npeixoto64/ExitGuardian/docs/requirements/requirements.md

# Project Requirements

## 1. Introduction

**Project Name:** Exit Guardian
**Version:** v3.0.0
**Author(s):** Nuno Peixoto
**Date:** 26/04/2026
**Purpose:** A plug-in device that triggers an alert with a buzzer at the moment the exit door is open if any window/door is previously opened. When the exit door is closed, the alert is always turned off. The device is intended for use in residential and commercial buildings.

## 2. Overall System Requirements

```{req} System composed of wireless sensors and a single gateway
:id: SR_001
:status: approved
:component: system

The system shall be composed of one or more wireless sensors for windows/doors, one main-door sensor and a gateway.
```

```{req} Window/door sensors and main-door sensors type
:id: SR_002
:status: approved
:component: system

The windows/doors and main-door sensor are the same. They are differentiated at the pairing moment with the gateway.
```

```{req} Sensor reports window/door open close events, user forced update status events and pair/unpair requests
:id: SR_003
:status: approved
:component: sensor

The wireless sensors shall send to the gateway, via RF, the current state of the monitored window/door (OPEN or CLOSED) together with a request field (PAIR_REQUEST, UNPAIR_REQUEST or NONE). A packet shall be sent on every window or door open/close event and on every sensor push-button press.
```

```{req} Sensor powered by replaceable battery
:id: SR_004
:status: approved
:component: sensor

The wireless sensors shall be powered by a replaceable battery.
```

```{req} Main-door sensor
:id: SR_005
:status: approved
:component: sensor

The main-door sensor is a regular window/door sensor but it's paired as a main door sensor. When an open door event is sent, the gateway evaluates the status of other sensors in its internal memory and beeps in case an window or door is open. When the door sends a close event the beep ends.
```

```{req} Gateway power supply
:id: SR_006
:status: approved
:component: gateway

The gateway shall be powered by 230 V AC, directly from wall power socket.
```

```{req} Gateway buzzer
:id: SR_007
:status: approved
:component: gateway

The gateway shall have a buzzer.
```

```{req} Gateway button for reset and pairing
:id: SR_008
:status: approved
:component: gateway

The gateway shall have a push button to allow a hard factory reset and to pair/unpair the sensors.
```

```{req} Gateway LEDs
:id: SR_009
:status: approved
:component: gateway

The gateway shall have three LEDs (blue, yellow, and red) to indicate its status.
```

```{req} LED usage (heartbeat, config, alerts)
:id: SR_010
:status: approved
:component: gateway

The gateway shall use LEDs to indicate:
  - heartbeat — blue;
  - sensors low-battery condition (visible only in monitoring mode) and pairing/unpairing mode — yellow;
  - waiting-for-configuration and active alert — red.
```

## 3. System Functional Requirements

```{req} Sensor sends a packet on window/door open/close event or push-button event
:id: FR_001
:status: approved
:component: sensor

When the monitored window/door or main-door is opened or closed, or when the sensor push button is pressed, the sensor shall send a data packet to the gateway via RF.
```

```{req} Sensor packet contents
:id: FR_002
:status: approved
:component: sensor

Each sensor packet shall include:
  (a) the sensor's unique identifier (FR_003);
  (b) battery status — LOW (Vbat < threshold) or OK;
  (c) packet type ∈ {OPEN, CLOSE}, reflecting the current state of the monitored window/door at the time of transmission;
  (d) request type ∈ {PAIR_REQUEST, UNPAIR_REQUEST, NONE}, set to PAIR_REQUEST or UNPAIR_REQUEST when the packet is triggered by the sensor push button, and NONE otherwise.
```

```{req} Unique sensor ID
:id: FR_003
:status: approved
:component: sensor

Each sensor shall have a unique identifier (ID).
```

```{req} Blue LED heartbeat
:id: FR_004
:status: approved
:component: gateway

The gateway shall indicate it is operating properly by blinking the blue LED for 100 ms every two seconds since boot, in any operation mode.
```

```{req} Gateway operating modes
:id: FR_005
:status: approved
:component: gateway

The gateway shall support 3 modes of operation: waiting-for-configuration, pairing/unpairing sensors and monitoring.
```

```{req} Boot-time mode selection
:id: FR_006
:status: approved
:component: gateway

After boot, the gateway shall restore the paired sensor list and status from NVM and enter monitoring mode if at least one sensor is paired, otherwise waiting-for-configuration mode.
```

```{req} Red LED ON in waiting-for-configuration
:id: FR_007
:status: approved
:component: gateway

In waiting-for-configuration mode, the red LED shall remain ON continuously.
```

```{req} Red LED OFF in monitoring mode if no alert
:id: FR_008
:status: approved
:component: gateway

In monitoring mode with no active alert, the red LED shall remain OFF.
```

```{req} Factory reset enters waiting-for-configuration mode
:id: FR_009
:status: approved
:component: gateway

After a factory RESET event, the gateway shall enter waiting-for-configuration mode of operation.
```

```{req} Yellow LED functionality in waiting-for-configuration mode
:id: FR_010
:status: approved
:component: gateway

While in waiting-for-configuration mode, the yellow LED shall be OFF.
```

```{req} Monitor main-door open/close
:id: FR_011
:status: approved
:component: gateway

In monitoring mode, if the gateway receives a main-door open or close event it shall evaluate the alert logic.
```

```{req} Alert logic based on main-door and windows/doors
:id: FR_012
:status: approved
:component: system

In monitoring mode, the gateway shall maintain the last-known open/closed state of each paired sensor on windoes/doors. The alert condition shall be evaluated whenever the main door state changes or any paired sensor reports a state change, using the main-door state and the last-known state of each paired sensor: ALERT ⇔ (main door OPEN) ∧ (∃ paired sensor with last-known state OPEN). On entry to monitoring mode, each paired sensor's last-known state shall be initialized from NVM (NFR_008). Sensors with no prior report shall default to CLOSED.
```

```{req} Alert signal pattern
:id: FR_013
:status: approved
:component: gateway

After the alert condition (FR_012) becomes true, within 500 ms, the gateway shall:
  - (a) sound the buzzer for an intentional single 2 s ON pulse, and
  - (b) start blinking the red LED with a 200 ms period and 50% duty cycle.
 The red LED shall continue blinking while the alert condition remains true (any window open). When the alert condition becomes false, the buzzer pulse shall be truncated and the red LED shall return to the indication corresponding to the current operating mode (FR_007 / FR_008).
```

```{req} Push button short press or double press enters pairing/unpairing mode for window/door sensor and main-door sensor
:id: FR_014
:status: approved
:component: gateway

If the gateway is in monitoring or waiting-for-configuration mode and the push button is pressed and released in less or equal 2 s, or the push button is double pressed the gateway shall enter pairing/unpairing mode.
```

```{req} Only one main-door sensor is supported
:id: FR_015
:status: approved
:component: gateway

If a pairing request from a new (unpaired) sensor ID is received during main-door pairing mode (FR_023), it shall replace the existing main-door sensor in NVM. Pairing requests from the currently registered main-door sensor ID shall be ignored per FR_020.
```

```{req} Pairing/unpairing mode indicators and timeout
:id: FR_016
:status: approved
:component: gateway

In pairing/unpairing mode, the gateway shall wait up to 20 s for a pair/unpair packet. 
Indication cadences during this window shall depend on the mode entered (FR_023):
  - Window/Door Pairing Mode (Single Press): Yellow LED flashes 500 ms ON / 500 ms OFF; 
    Buzzer beeps 500 ms ON / 500 ms OFF.
  - Main-Door Pairing Mode (Double Press): Yellow LED flashes 100 ms ON / 100 ms OFF (double flash per second); 
    Buzzer beeps 100 ms ON / 100 ms OFF (double beep per second).
If no valid packet is received within 20 s, the gateway shall exit pairing/unpairing mode and restore LED indicators per FR_025.
```

```{req} In pairing/unpairing mode the alerts are suspended
:id: FR_017
:status: approved
:component: gateway

While in pairing/unpairing mode, the gateway shall not evaluate or trigger the alert condition (FR_012).
```

```{req} Exit pairing/unpairing mode
:id: FR_018
:status: approved
:component: gateway

If the gateway is in pairing/unpairing mode of operation it shall exit and return to its previous mode of operation (waiting-for-configuration if no sensors are paired, otherwise monitoring) on any of the following conditions:
  - The gateway push button is short-pressed once.
  - The 20 s timeout is reached.
  - A sensor is successefully paired/unpaired.
```

```{req} Pair sensor confirmation
:id: FR_019
:status: approved
:component: gateway

In case a pairing request from a new sensor ID is received in pairing/unpairing mode of operation, the gateway shall add it to the monitored sensors list, stop the pairing-mode yellow blinking and pairing beep, sound the buzzer continuously for 2 seconds and exit pairing/unpairing mode of operation and return to monitoring mode.
```

```{req} Known sensor ID pairing request handling
:id: FR_020
:status: approved
:component: gateway

In case a pairing request from an existing sensor ID is received in pairing/unpairing mode of operation, the gateway shall ignore it, the pairing beep and pairing yellow blink shall stop and exit pairing/unpairing mode of operation.
```

```{req} Unpair sensor confirmation
:id: FR_021
:status: approved
:component: gateway

In case an unpairing request from a known sensor ID is received in pairing/unpairing mode of operation, the gateway shall remove it from the monitored sensors list, stop the pairing-mode yellow blinking and pairing beep, sound the buzzer continuously for 2 seconds and exit pairing/unpairing mode of operation and return to waiting-for-configuration mode if no sensors remain paired, otherwise to monitoring mode.
```

```{req} Unknown sensor ID unpairing request handling
:id: FR_022
:status: approved
:component: gateway

In case an unpairing request from an unknown (non-paired) sensor ID is received in pairing/unpairing mode of operation, the gateway shall ignore it, the pairing beep and pairing yellow blink shall stop and exit pairing/unpairing mode of operation.
```

```{req} Differentiate window/door sensors from main-door sensor
:id: FR_023
:status: approved
:component: gateway

When the pairing/unpairing mode is triggered by a single push button press it only allows the pairing of window/door sensors.
When the pairing/unpairing mode is triggered by a double push button press it only allows the pairing of main-door sensor.
```

```{req} Indicate sensor low battery via yellow + blue sync
:id: FR_024
:status: approved
:component: gateway

In monitoring mode, if at least one paired sensor's last-reported battery status is LOW, the yellow LED shall flash for 100 ms every 2 s, in phase with the blue heartbeat (FR_004).
```

```{req} Yellow LED functionality in pairing/unpairing mode
:id: FR_025
:status: approved
:component: gateway

While in pairing/unpairing mode, the yellow LED shall follow the pairing-mode pattern (FR_016) and the low-battery indication (FR_024) shall be suspended. On exit from pairing/unpairing mode, the yellow LED state shall follow FR_024 or FR_010.
```

```{req} Long-press triggers factory reset
:id: FR_026
:status: approved
:component: gateway

If the push button is held for ≥ 5 s, the gateway shall blink all LEDs at a 200 ms period and 50% duty cycle for the remainder of the press; on release after the 5 s threshold, a factory RESET shall occur.
```

```{req} Push button press
:id: FR_027
:status: approved
:component: gateway

A press released between 2 s and 5 s shall be ignored (no mode change, no factory RESET).
```

```{req} Post-reset has no paired sensors
:id: FR_028
:status: approved
:component: gateway

After a factory RESET, the gateway shall have no sensors attached, being in waiting-for-configuration mode of operation.
```

```{req} Gateway ACK
:id: FR_029
:status: approved
:component: gateway

There is no ACK from gateway to sensor when packets are received.
```

## 4. System Non-Functional Requirements

```{req} Indoor RF range
:id: NFR_001
:status: approved
:component: system

≥ 99% packet delivery success at 20 m indoors through two 20 cm concrete walls, measured over 1000 packets at the operating frequency.
```

```{req} Sensor battery life ≥ 3 years
:id: NFR_002
:status: approved
:component: sensor

Sensor battery life ≥ 3 years assuming ≤ 4 events/day at 25 °C with the specified battery (e.g., CR2032).
```

```{req} Buzzer beep level
:id: NFR_003
:status: approved
:component: gateway

The buzzer SPL shall be ≥ 85 dB(A) and ≤ 95 dB(A) at 1 m, measured in a free field.
```

```{req} Watchdog for hard reset
:id: NFR_004
:status: approved
:component: gateway

The gateway shall have a watchdog to perform a hard RESET in case the superloop takes more than 1 second to fully execute.
```

```{req} Pairing and unpairing supported
:id: NFR_005
:status: approved
:component: gateway

The gateway shall allow pairing and unpairing of sensors.
```

```{req} User config via button + LEDs
:id: NFR_006
:status: approved
:component: gateway

End-user configuration shall be performed via a push button and three LEDs.
```

```{req} Stable sensor list in NVM
:id: NFR_007
:status: approved
:component: gateway

The gateway shall maintain the list of paired sensors in non-volatile memory (NVM) so that pairings are preserved across power loss and resets (other than factory RESET, see FR_026).
```

```{req} Persist sensor status in NVM
:id: NFR_008
:status: approved
:component: gateway

The gateway shall persist, in NVM, for each paired sensor, at least: unique identifier, last reported open/close state, and last reported battery status, so that operation resumes consistently after power loss.
```

```{req} GFSK modulation for RF link
:id: NFR_009
:status: approved
:component: system

The RF link between sensors and gateway shall use Gaussian Frequency Shift Keying (GFSK) modulation.
```

## 5. System Assumptions & Constraints

- Security is not a critical factor.
- There is no acknowledge of the gateway to messages sent by the sensors. 
- No tamper detection or advanced security features.
- System operates in 0–40 °C, 10–90% RH, non-condensing.

## 6. Legal & Regulatory Requirements

```{req} CE compliance
:id: LR_001
:status: approved
:component: system

Device shall comply with CE marking requirements (Low Voltage Directive, EMC Directive).
```

```{req} EU RF compliance (868 MHz ISM)
:id: LR_002
:status: approved
:component: system

RF module shall operate only on frequencies allowed in the EU (e.g., 868 MHz ISM band, duty cycle limits).
```

```{req} RoHS / REACH compliance
:id: LR_003
:status: approved
:component: system

Materials must comply with RoHS / REACH.
```

```{req} EU Battery Directive compliance
:id: LR_004
:status: approved
:component: system

Product must comply with EU Battery Directive for labeling and recycling.
```

## 7. Open Issues

- Behaviour upon loss of communication with a paired sensor (e.g., RF link timeout, sensor failure) is not yet specified. To be defined in a future revision.

## 8. Traceability

- None.

## 9. Glossary

**Buzzer:** Device that produces a sound for alerts.  
**CE Marking:** EU conformity certification.  
**Duty Cycle:** % of a period when a signal is active.  
**Factory RESET:** Restores device to original settings.  
**Gateway:** Central device that receives data and manages alerts.  
**GFSK:** Gaussian Frequency Shift Keying. Digital modulation scheme that applies a Gaussian filter to the data signal before frequency-shift keying to reduce spectral bandwidth.  
**LED:** Light Emitting Diode. Indicator for system status.  
**Low Voltage Directive:** EU directive for electrical safety.  
**MCU:** Microcontroller Unit.  
**NVM:** Non-Volatile Memory.  
**RF:** Radio Frequency communication.  
**RoHS / REACH:** EU environmental compliance directives.  
**Sensor:** Wireless device detecting window/door events.  
**Watchdog:** Timer that resets system if program fails.
