npeixoto64/ExitGuardian/docs/architecture/overview.md

# Architecture Overview

This section contains the architecture documentation and diagrams.

```{toctree}
:maxdepth: 1

context
container
sensor
gateway_hw
gateway_sw
state_machine
design_decisions
