npeixoto64/ExitGuardian/docs/architecture/sensor.md

# Sensor Block Diagram

```{uml}
@startuml
!include diagrams/sensor_hw_arch.puml
@enduml
