npeixoto64/ExitGuardian/finance/budgets/budget_plan.md

# Budget Plan 2025

## 1. Overview
- **Project:** [Project Name]
- **Period:** Sep–Dec 2025
- **Currency:** EUR
- **Funding sources:** Self-funding
- **Prepared by:** Nuno Peixoto
- **Last updated:** 2025-09-10

---

## 2. Assumptions
- Prototype phase requires **2 PCB spins** and **2 mechanical iterations**.
- Assembly run at QTY 5-10 before pilot.

---

## 3. Budget Allocation (planned)

| Category | Cap (€) | Notes |
|---|---|---|
| Prototype  | 200 | PCB fabs, components, stencils, lab supplies |
| Tooling | 200 | 3D printing, machining, molds, jigs |
| Licenses | 50 | SW subscriptions |
| **Total**  | 450 | |

---

## 5. Funding Plan
| Source | Amount (€) | Date | Notes |
|---|---|---|---|
| Self | 500 | 2025-09  | Initial injection |

---

## 6. Planned vs. Actual (to be updated)

| Category | Planned (€) | Actual (€) | Variance (€) | Notes |
|---|---|---|---|---|
| Prototype  | 200 | TBD | TBD | |
| Tooling | 200 | TBD | TBD | |
| Licenses | 50 | 23 | TBD | ChatGPT Plus (1 month) |
| Contingency| 50 | TBD | TBD | |
| **Total**  | 500 | TBD | TBD | |

---

## 7. Approval & Revision History
- **Version 1.0 (2025-09-10)** — Initial draft
