npeixoto64/ExitGuardian/finance/current_cost_summary.md

# Cost Summary — current
- Total spent (10/09/2025): 148.3 €
- Remaining vs. budget: 351.7 €
- Top 3 cost drivers: N/A
- Upcoming commitments (30d): 0 €
- Burn per month (last 90d): 0 €
