npeixoto64/ExitGuardian/hardware/sensor/rev1/output/PCBA/window_sensor_BOM.csv

Id | Designator | Footprint | Quantity | Designation | Supplier and ref
1 | ANT1 | Antenna_hole | 1 | ~
2 | BT1 | CST2032 | 1 | CST2032
3 | C1 | GRM31x | 1 | GRM31CR61A107MEA8L
4 | C2 | C_0603_1608Metric | 1 | 1nF
5 | C3 | C_0603_1608Metric | 1 | 100nF
6 | C4 | C_0603_1608Metric | 1 | 10nF
7 | C5, C6, C7, C9, C10, C11, C51 | C_0402_1005Metric | 7 | 100nF
8 | C81, C101 | C_0402_1005Metric | 2 | 15pF
9 | C121 | C_0402_1005Metric | 1 | 1pF
10 | C122, C131 | C_0402_1005Metric | 2 | 1.5pF
11 | C123 | C_0402_1005Metric | 1 | 3.3pF
12 | C124 | C_0402_1005Metric | 1 | 100pF
13 | C125 | C_0402_1005Metric | 1 | 12pF
14 | CLK1 | TestPoint_Pad_D1.0mm | 1 | SPI_CK
15 | CS1 | TestPoint_Pad_D1.0mm | 1 | SPI_CS
16 | D1 | 645-597-3008-207F | 1 | 597-3008-207F
17 | FB1 | BLM18SP221SN1B | 1 | BLM18KG601SN1D
18 | GD0 | TestPoint_Pad_D1.0mm | 1 | GD0
19 | IC1 | SOP65P640X120-20N | 1 | STM8L051F3P6
20 | IC2 | QFN50P400X400X100-21N-D | 1 | CC1101RGPR
21 | J1 | HDRV4W66P0X254_1X4_1016X249X1067P | 1 | 22-28-4044
22 | J2 | HDRV3W66P0X254_1X3_762X254X855P | 1 | M20-9770342
23 | L121, L123, L124, L131 | L_0402_1005Metric | 4 | 12nH
24 | L122, L132 | L_0402_1005Metric | 2 | 18nH
25 | LED2 | TestPoint_Pad_D1.0mm | 1 | LED
26 | M1, M2, M5, M6 | MountingHole_1.7mm | 4 | ~
27 | MCUVDD1 | TestPoint_Pad_D1.0mm | 1 | MCU_VDD
28 | MISO1 | TestPoint_Pad_D1.0mm | 1 | SPI_MISO
29 | MOSI1 | TestPoint_Pad_D1.0mm | 1 | SPI_MOSI
30 | R1 | R_0603_1608Metric | 1 | 120
31 | R2 | R_0603_1608Metric | 1 | 2.2M
32 | R171 | R_0402_1005Metric | 1 | 56K
33 | RFVDD1 | TestPoint_Pad_D1.0mm | 1 | RF_VDD
34 | S1, S3 | GP5602025 | 2 | GP560_20-25
35 | S2 | PTS810SJK250SMTRLFS | 1 | PTS810SJK250SMTR_LFS
36 | Y1 | NX3225GA26000MSTDCRG2 | 1 | NX3225GA-26MHZ-TI
