npeixoto64/ExitGuardian/docs/references/application_notes/gateway/433MHz/CC1101EM_434MHz_PARTLIST_2_0_0.xls

CC1101EM 434 MHz Partlist 2.0.0
This list is automatically linked up to the G:\06_TEKNISK\06H_Cadstar\purchase_library\PurchaseLib.xls
Enter columns in green
Ref. | Part name | Pcs/unit | Description | Manufacturer | Part number | Supplier | Ordering code | Alt. Manufacturer | Alt. Part number | Alt. Supplier | Alt. Ordering code | Comments
U1 | CC1101 | 1 | Single-chip transceiver | TI | CC1101 | TI | CC1101 |  |  |  |  | Supplied by Chipcon
C41;C51 | C_100N_0402_X5R_K_10 | 2 | Capacitor, 100n, 0402, X5R, 10%, 10V | Murata | GRM155R71A104KA01D
C91;C141 | C_10N_0402_X7R_K_25 | 2 | Capacitor, 10n, 0402, X7R, 10%, 25V | Murata | GRM155R71E103KA01D
C81 | C_12P_0402_NP0_J_50 | 1 | Capacitor, 12p, 0402, NP0, 5%, 50V | Murata | GRM1555C1H120JZ01D
C101 | C_15P_0402_NP0_J_50 | 1 | Capacitor, 15p, 0402, NP0, 5%, 50V | Murata | GRM1555C1H150JZ01D
C1 | C_1U_0805_X7R_K_16 | 1 | Capacitor, 1u, 0805, X7R, 10%, 16V | Murata | GRM21BR71C105KA01L | ELFA | 65-809-71
C111;C124-125;C151;C181 | C_220P_0402_NP0_J_50 | 5 | Capacitor, 220p, 0402, NP0, 5%, 50V | Murata | GRM1555C1H221JA01D
C121;C131 | C_3P9_0402_NP0_C_50 | 2 | Capacitor, 3p9, 0402, NP0, +-0.25pF, 50V | Murata | GRM1555C1H3R9CZ01D
C123 | C_5P6_0402_NP0_C_50 | 1 | Capacitor, 5p6, 0402, NP0, +-0.25pF, 50V | Murata | GRM1555C1H5R6CZ01D
C122 | C_8P2_0402_NP0_C_50 | 1 | Capacitor, 8p2, 0402, NP0, +-0.25pF, 50V | Murata | GRM1555C1H8R2CZ01D
L122 | L_22N_0402_J | 1 | Inductor, 22n, 0402, ±5% | Murata | LQG15HS22NJ02D | ACTE
L121;L123;L131 | L_27N_0402_J | 3 | Inductor, 27n, 0402, ±5% | Murata | LQG15HS27NJ02D | ACTE
L1 | L_BEAD_102_0402 | 1 | EMI filter bead, 0402 1Kohms Tape GHz Band Gen Use | Murata | BLM15HG102SN1D | ACTE
R171 | R_56K_0402_F | 1 | Resistor, 56k ohms, 0402, ±1% | Koa | RK73H1ETTP5602F | ELFA | 60-488-96
P3 | SMA_SMD | 1 | SMA connector, straight SMD-mount | Hus-Tsan Group Taiwan | SMA-10V21-TGG | EC Partner A/S | SMA-10V21-TGG
P1-2 | SMD_SOCKET_2x10 | 2 | SMD pinrow socket, .050 spacing, 2x10 | Samtec | SFM-110-02-SM-D-A-K-TR | Abacus
X1 | X_26.000/20/40/40/10 | 1 | Crystal, 26.000000MHz, 10.0pF, 50 ohms max, 20/40 ppm, -40C to +85C | NDK | NX3225GA, EXS00A-CG01972 | NDK | NX3225GA, EXS00A-CG01972
 |  | 27
