npeixoto64/ExitGuardian/docs/references/application_notes/gateway/868MHz/CC1101_CC1190EM_869MHz_PARTLIST_2_1_0.xls

CC1101-CC1190EM 869 MHz rev 2.1.0
Ref. | Part name | Pcs/unit | Description | Manufacturer | Part number | Supplier | Ordering code | Alt. Manufacturer | Alt. Part number | Alt. Supplier | Alt. Ordering code | Comments
U1 | CC1101 | 1 | Single-chip transceiver | TI | CC1101 | TI | CC1101
U2 | CC1190 | 1 | LNA and PA 26 dBm | TI | CC1190 | TI | CC1190
C41;C51;C91;C111;C141;C151;C181 | C_100N_0402_X5R_K_10 | 7 | Capacitor, 100n, 0402, X5R, 10%, 10V | Murata | GRM155R71A104KA01D
C124 | C_100P_0402_NP0_J_50 | 1 | Capacitor, 100p, 0402, NP0, 5% 50V | Murata | GRM1555C1H101JZ01D
C2 | C_10U_0603_X5R_M_4 | 1 | Capacitor, 10u, 0603, X5R, 20%, 4V | Murata | GRM188R60G106ME47D
C22;C52;C81 | C_12P_0402_NP0_J_50 | 3 | Capacitor, 12p, 0402, NP0, 5%, 50V | Murata | GRM1555C1H120JZ01D
C25;C101 | C_15P_0402_NP0_J_50 | 2 | Capacitor, 15p, 0402, NP0, 5%, 50V | Murata | GRM1555C1H150JZ01D
C132 | C_18P_0402_NP0_J_50 | 1 | Capacitor, 18p, 0402, NP0, 5% 25V | Murata | GRM1555C1H180JZ01D | ELFA | 65-881-23
C27 | C_1N_0402_NP0_J_50 | 1 | Capacitor, 1n, 0402, NP0, 5%, 50V | Murata | GRM1555C1H102JA01D
C121 | C_1P0_0402_NP0_C_50 | 1 | Capacitor, 1p, 0402, NP0, +/-0.25pF 50V | Murata | GRM1555C1H1R0CZ01D
C122;C131 | C_1P5_0402_NP0_C_50 | 2 | Capacitor, 1p5, 0402, NP0, +-0.25pF, 50V | Murata | GRM1555C1H1R5CZ01D
C1;C29 | C_1U_0402_X5R_K_6P3 | 2 | Capacitor, 1u, 0402, X5R, 10%, 6.3V | Murata | GRM155R60J105KE19D
C3 | C_220P_0402_NP0_J_50 | 1 | Capacitor, 220p, 0402, NP0, 5%, 50V | Murata | GRM1555C1H221JA01D
C21 | C_2P2_0402_NP0_C_50 | 1 | Capacitor, 2p2, 0402, NP0, +-0.25pF, 50V | Murata | GRM1555C1H2R2CZ01
C125 | C_2P7_0402_NP0_C_50 | 1 | Capacitor, 2p7, 0402, NP0, +-0.25pF, 50V | Murata | GRM1555C1H2R7CZ01D
C161 | C_33P_0402_NP0_J_50 | 1 | Capacitor, 33p, 0402, NP0, 5%, 50V | Murata | GRM1555C1H330JZ01D
C28;C30;C123 | C_47P_0402_NP0_J_50 | 3 | Capacitor, 47p, 0402, NP0, 5%, 50V | Murata | GRM1555C1H470JZ01D
C23-24 | C_5P6_0402_NP0_C_50 | 2 | Capacitor, 5p6, 0402, NP0, +-0.25pF, 50V | Murata | GRM1555C1H5R6CZ01D
C26 | C_9P1_0402_NP0_C_50 | 1 | Capacitor, 9p1, 0402, NP0, +-0.25pF, 50V | Murata | GRM1555C1H9R1CA01D
U3 | EPCOS_B3725 | 1 | SAW filter, 869 MHz | EPCOS | B3725 | Arrow | B39871B3725U410
L22 | L_10N_0402_J_LQW | 1 | Inductor, 10n, 0402, ±5%, wire-wound type | Murata | LQW15AN10NJ00D
L2 | L_11N_0402_J_LQW | 1 | Inductor, 11n, 0402, ±5%, wire-wound type | Murata | LQW15AN11NJ00
L121;L131 | L_12N_0402_J_LQW | 2 | Inductor, 12n, 0402, ±5%, wire-wound type | Murata | LQW15AN12NJ00D
L21 | L_15N_0603_J_LQW | 1 | Inductor, 15n, 0603, ±5%, wire-wound type | Murata | LQW18AN15NJ00
L122;L132 | L_18N_0402_J_LQW | 2 | Inductor, 18n, 0402, ±5%, wire-wound type | Murata | LQW15AN18NJ00D
L26;L130 | L_1N5_0402_S | 2 | Inductor, 1n5, 0402, Monolithic type, +/-0.3 nH | Murata | LQG15HS1N5S02D |  |  | Coilcraft
L23;L25 | L_2N2_0402_C_LQW | 2 | Inductor, 2n2, 0402, wire-wound type, +/- 0.2 nH | Murata | LQW15AN2N2C10D
L24 | L_4N1_0402_C_LQW | 1 | Inductor, 4n1, 0402, +/-0.2nH, wire-wound type | Murata | LQW15AN4N1C00 | ACTE
L133 | L_8N2_0402_J | 1 | Inductor, 8n2, 0402, ±5% | Murata | LQG15HS8N2J02D | ACTE |  | Coilcraft
L1 | L_BEAD_102_0402 | 1 | EMI filter bead, 0402 1k ohms Tape GHz Band Gen Use | Murata | BLM15HG102SN1D | ACTE
P4 | PINROW_SMD_2X7_2.54MM_PEG | 1 | 2x7 pinrow, 2.54mm pitch, SMD type with locating peg | GradConn | BB02-HP141-KB3-060A00 | Freber
R3-5 | R_10K_0402_F | 3 | Resistor, 10k ohms, 0402, ±1% | Koa | RK73H1ETTP1002F | ELFA | 60-485-32
R141 | R_3K3_0402_F | 1 | Resistor, 3k3 ohms, 0402, ±1% | Koa | RK73H1ETTP3301F | ELFA | 60-482-92
R171 | R_56K_0402_F | 1 | Resistor, 56k ohms, 0402, ±1% | Koa | RK73H1ETTP5602F | ELFA | 60-488-96
P3 | SMA_SMD | 1 | SMA connector, straight SMD-mount | Hus-Tsan Group Taiwan | SMA-10V21-TGG | EC Partner A/S | SMA-10V21-TGG |  |  | AFU, Arrow
P1-2 | SMD_SOCKET_2x10 | 2 | SMD pinrow socket, .050 spacing, 2x10 | Samtec | SFM-110-02-SM-D-A-K-TR | Abacus |  |  |  | AFU, Arrow
X1 | X_27.000/20/40/40/10 | 1 | Crystal, 27.000000MHz, 10.0pF, 50 ohms max. | NDK | NX3225GA, EXS00A-CG01973 | NDK | NX3225GA, EXS00A-CG01973
Total number of components |  | 58
