npeixoto64/ExitGuardian/hardware/gateway/rev2/production/bom.csv

Designator | Footprint | Quantity | Value | LCSC Part #
C1 | 0402 | 1 | 10nF
C10, C11, C3, C5, C50, C51, C6, C7, C9 | 0402 | 9 | 100nF
C101, C81 | 0402 | 2 | 15pF
C121 | 0402 | 1 | 1pF
C122, C131 | 0402 | 2 | 1.5pF
C123 | 0402 | 1 | 3.3pF
C124 | 0402 | 1 | 100pF
C125 | 0402 | 1 | 12pF
C2, C4 | 0402 | 2 | 1uF
FB1 | BLM18SP221SN1B | 1 | BLM18KG601SN1D
IC1 | QFP80P900X900X160-32N | 1 | STM8L151K4T6
IC2 | QFN50P400X400X100-21N-D | 1 | CC1101RGPR
IC5 | SOIC127P602X173-8N | 1 | MB85RC64TAPNF-G-BDERE1
L121, L123, L124, L131 | 0402 | 4 | 12nH
L122, L132 | 0402 | 2 | 18nH
LS1 | PKMCS1818E20A0R1 | 1 | PKMCS1818E20A0-R1
R10, R9 | 0402 | 2 | 47
R11, R12, R20 | 0402 | 3 | 10K
R171 | 0402 | 1 | 56K
R18, R19 | 0402 | 2 | 100R
R8 | 0402 | 1 | 100
Y1 | NX3225GA26000MSTDCRG2 | 1 | NX3225GA-26MHZ-TI
