npeixoto64/ExitGuardian/finance/ledger/funding_log.csv

date | source | amount_eur | notes
2025-09-10 | self | 500.00 | Initial project funding
2025-09-06 | self | 500.00 | Extra project funding
