npeixoto64/ExitGuardian/docs/references/enclosures/sensor/3D/CST-2032M..stp

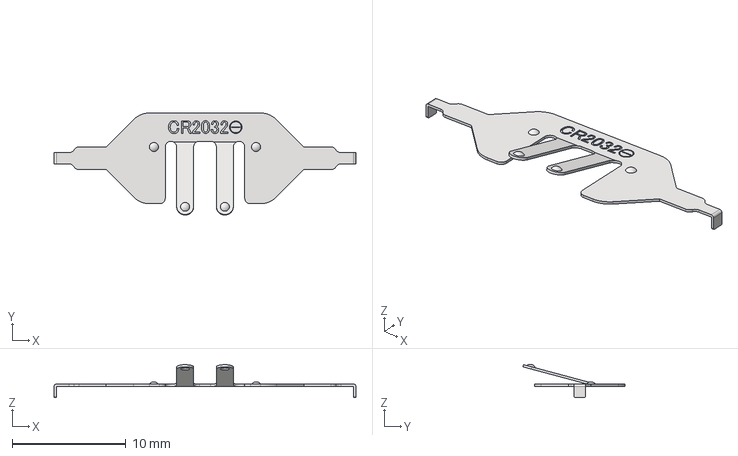
[picture p1: CAD file, 2026-07-28]
docs/references/enclosures/sensor/3D/CST-2032M..stp
26.6 x 9.00 x 2.94 mm
