npeixoto64/ExitGuardian/hardware/gateway/rev2/output/3D/gateway.step

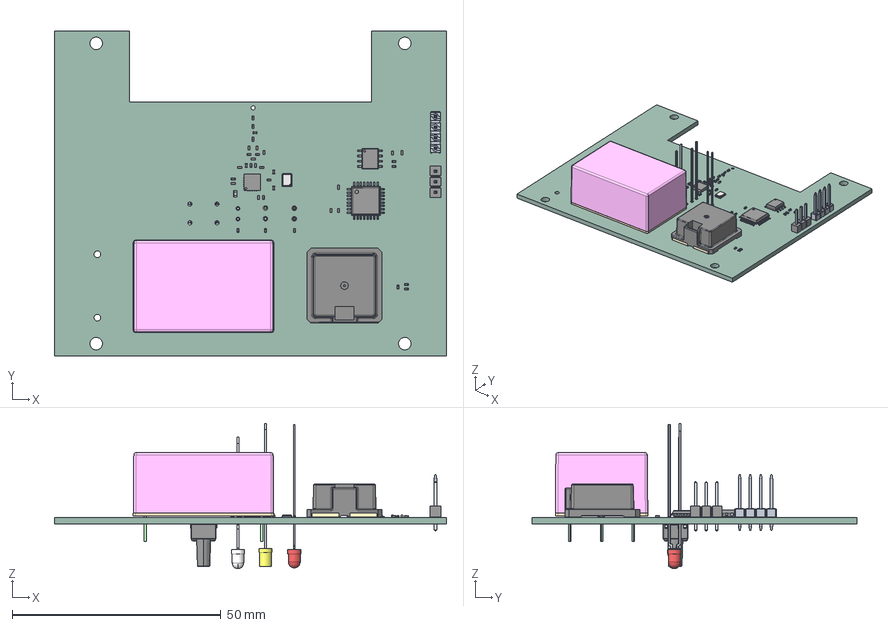
[picture p2: CAD file, 2026-11-03]
hardware/gateway/rev2/output/3D/gateway.step
94.0 x 78.0 x 34.9 mm
PinsArrayLR x 3
PinsArrayTB x 2
R_0402_1005Metric x 9
L_0402_1005Metric x 6
C_0402_1005Metric x 20
ThermalPin
NX3225GA-26.000M-STD-CRG-2
BLM18KG601SN1D
LeadsArray
_X2_4E0A84CB_X0__PRT_21_PRT_PRT.PRT
_X2_4E0B84CB_X0__PRT_1_1_33_PRT.PRT
PIN_14_4_PRT_PRT.PRT
PIN_14_3_PRT_PRT.PRT
PIN_14_2_PRT_PRT.PRT
PIN_14_1_PRT_PRT.PRT
PKMCS1818E20A0
CUI_DEVICES_TS02-66-100-BK-160-SCR-D
WP710A10LVBC-D
TLHR4400-AS12Z
solidLead
solidBody
gateway_rev2_PCB
