npeixoto64/ExitGuardian/hardware/sensor/rev1/output/3D/sensor.step

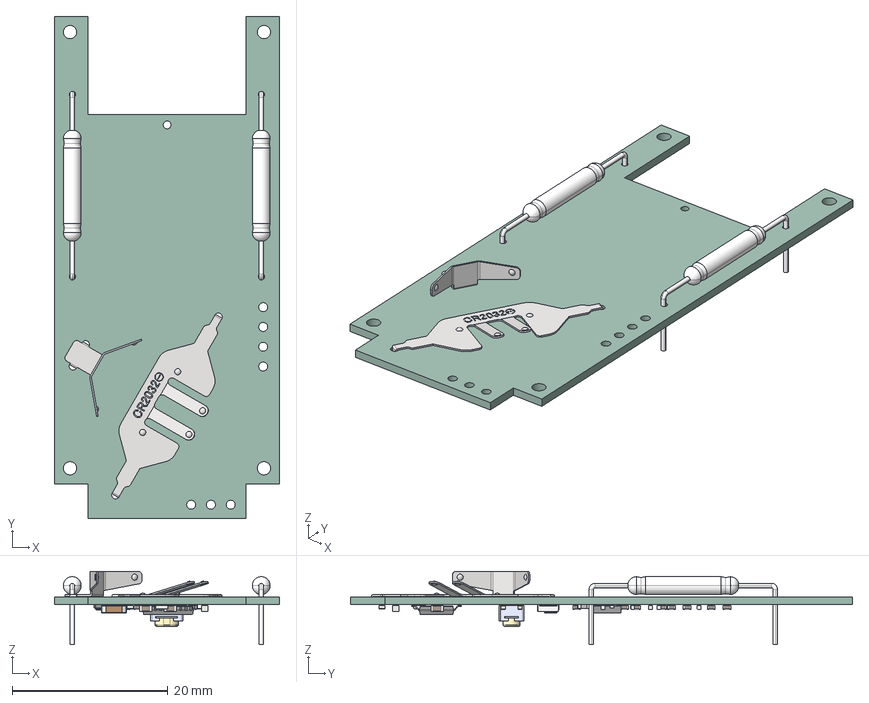
[picture p3: CAD file, 2026-08-29]
hardware/sensor/rev1/output/3D/sensor.step
28.9 x 64.5 x 9.41 mm
GP560-20-25 x 2
cst-2032m
cst-2032p
PTS810SJK250SMTR LFS
R_0402_1005Metric
C_0402_1005Metric x 15
NX3225GA-26.000M-STD-CRG-2
C_0603_1608Metric x 3
GCM31A5C2J820JX01J_3
GCM31A5C2J820JX01J_2
GCM31A5C2J820JX01J
BLM18KG601SN1D
L_0402_1005Metric x 6
597-3008-207F
ThermalPin
PinsArrayLR x 2
PinsArrayTB
R_0603_1608Metric x 2
sensor_rev1_PCB
