npeixoto64/ExitGuardian/hardware/sensor/sensor.step

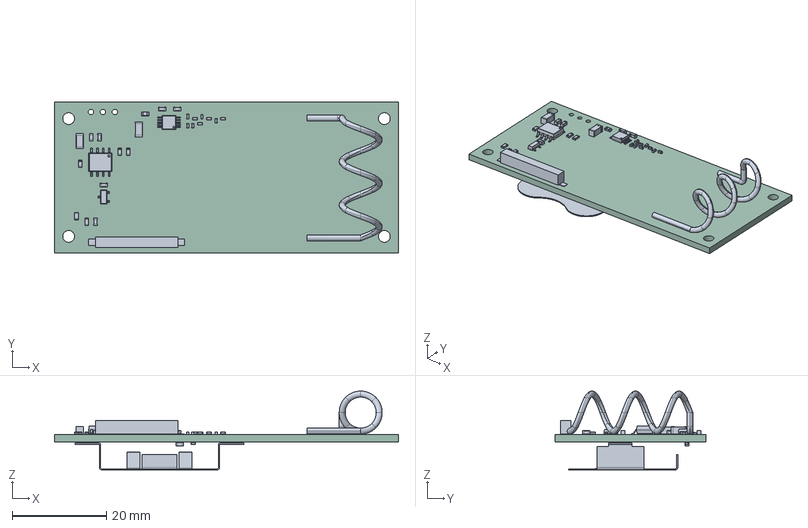
[picture p4: CAD file, 2025-10-16]
hardware/sensor/sensor.step
73.0 x 32.0 x 16.7 mm
C_0402_1005Metric x 6
C_0603_1608Metric x 6
Pins
PinsArrayLR x 2
L_0402_1005Metric x 4
R_0603_1608Metric x 5
BLM18KG601SN1D
BODY-SOT
LEAD-SOT x 3
PIN1-ID
TIEBAR
ANT-868-HESM
C_1206_3216Metric x 2
BAT-HLD-006-SMT
L_0603_1608Metric
sensor_PCB
