npeixoto64/ExitGuardian/mechanical/gateway/rev2/gateway.step

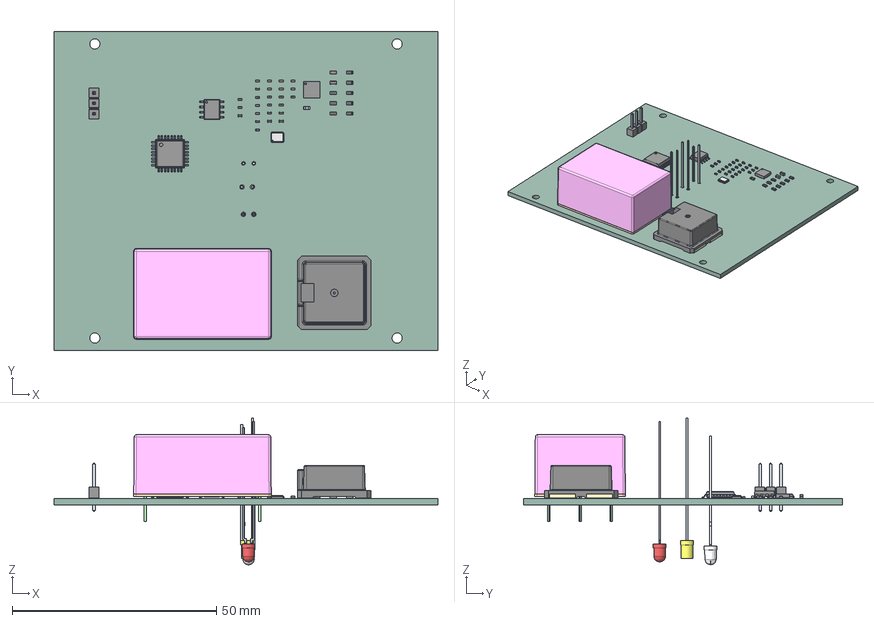
[picture p5: CAD file, 2026-11-03]
mechanical/gateway/rev2/gateway.step
94.0 x 78.0 x 35.9 mm
PinsArrayLR x 3
PinsArrayTB x 2
R_0603_1608Metric x 8
L_0402_1005Metric x 6
C_0402_1005Metric x 18
ThermalPin
NX3225GA-26.000M-STD-CRG-2
C_0603_1608Metric x 2
BLM18KG601SN1D
LeadsArray
_X2_4E0A84CB_X0__PRT_21_PRT_PRT.PRT
_X2_4E0B84CB_X0__PRT_1_1_33_PRT.PRT
PIN_14_4_PRT_PRT.PRT
PIN_14_3_PRT_PRT.PRT
PIN_14_2_PRT_PRT.PRT
PIN_14_1_PRT_PRT.PRT
R_0402_1005Metric
PKMCS1818E20A0
WP710A10LVBC-D
TLHR4400-AS12Z
solidLead
solidBody
gateway_rev2_PCB
