npeixoto64/ExitGuardian/mechanical/gateway/SIC6-12-4W.stp

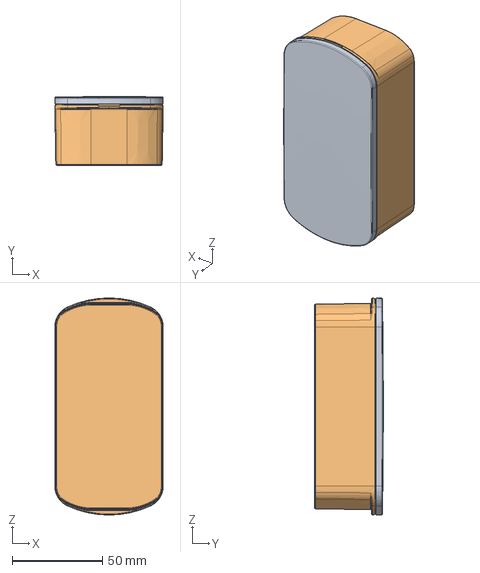
[picture p6: CAD file, 2025-10-16]
mechanical/gateway/SIC6-12-4W.stp
60.0 x 38.0 x 120.0 mm
6065_上カバー
60120下カバー_38
