npeixoto64/ExitGuardian/mechanical/sensor/rev1/Sensor.FCStd

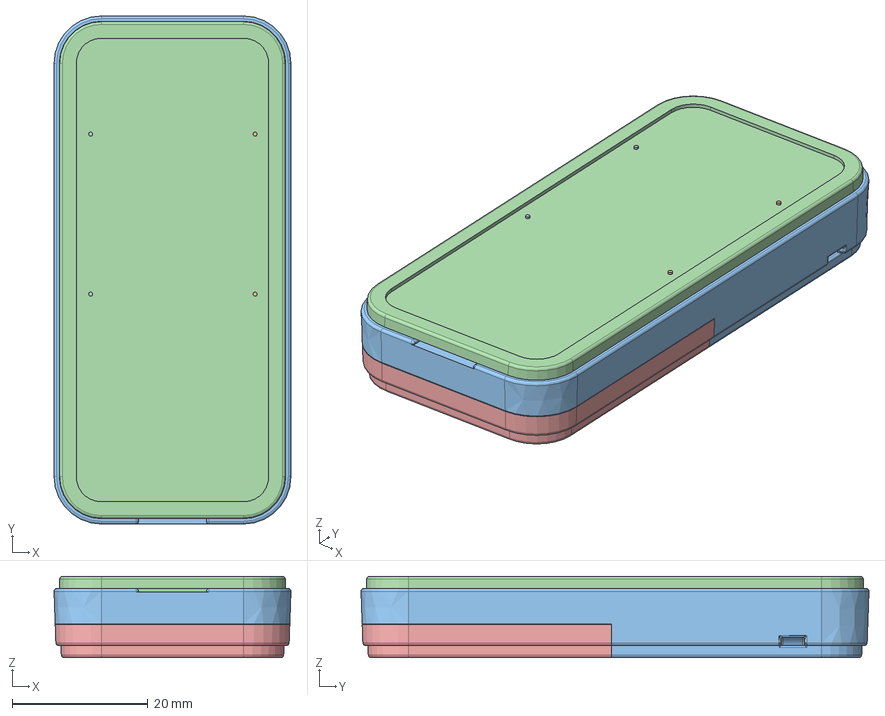
[picture p7: CAD file, 2026-08-31]
mechanical/sensor/rev1/Sensor.FCStd
35.0 x 75.0 x 12.0 mm
GP560-20-25
GP560-20-001
cst-2032m
cst-2032p
PTS810SJK250SMTR LFS
PTS810SJK250SMTR LFS001
PTS810SJK250SMTR LFS002
PTS810SJK250SMTR LFS003
PTS810SJK250SMTR LFS004
PTS810SJK250SMTR LFS005
PTS810SJK250SMTR LFS006
R_0402_1005Metric
C_0402_1005Metric
C_0402_1005Metric002
C_0402_1005Metric004
C_0402_1005Metric006
NX3225GA-26.000M-STD-CRG-2
NX3225GA-26.000M-STD-CRG-001
NX3225GA-26.000M-STD-CRG-002
NX3225GA-26.000M-STD-CRG-003
NX3225GA-26.000M-STD-CRG-004
NX3225GA-26.000M-STD-CRG-005
NX3225GA-26.000M-STD-CRG-006
NX3225GA-26.000M-STD-CRG-007
C_0402_1005Metric008
C_0402_1005Metric010
C_0402_1005Metric012
C_0603_1608Metric
C_0402_1005Metric014
C_0603_1608Metric002
GCM31A5C2J820JX01J_3
GCM31A5C2J820JX01J_2
GCM31A5C2J820JX01J
BLM18KG601SN1D
BLM18KG601SN1D001
BLM18KG601SN1D002
C_0402_1005Metric016
L_0402_1005Metric
L_0402_1005Metric002
597-3008-207F
597-3008-207F001
C_0402_1005Metric018
C_0402_1005Metric020
C_0402_1005Metric022
L_0402_1005Metric004
ThermalPin
PinsArrayLR
PinsArrayLR001
PinsArrayLR002
PinsArrayLR003
PinsArrayLR004
PinsArrayLR005
PinsArrayLR006
PinsArrayLR007
PinsArrayLR008
PinsArrayLR009
PinsArrayTB
PinsArrayTB001
PinsArrayTB002
PinsArrayTB003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
