npeixoto64/ExitGuardian/docs/references/enclosures/sensor/3D/CSPB-75.stp

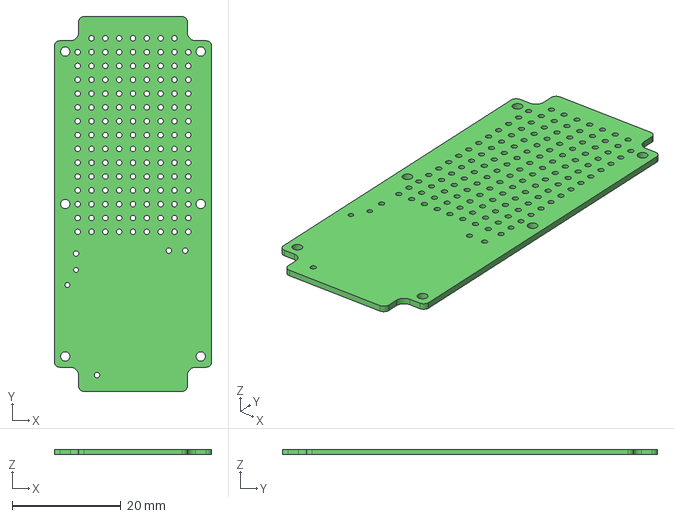
[picture p8: CAD file, 2026-07-28]
docs/references/enclosures/sensor/3D/CSPB-75.stp
28.9 x 68.9 x 1.00 mm
