npeixoto64/ExitGuardian/mechanical/gateway/gateway.FCStd

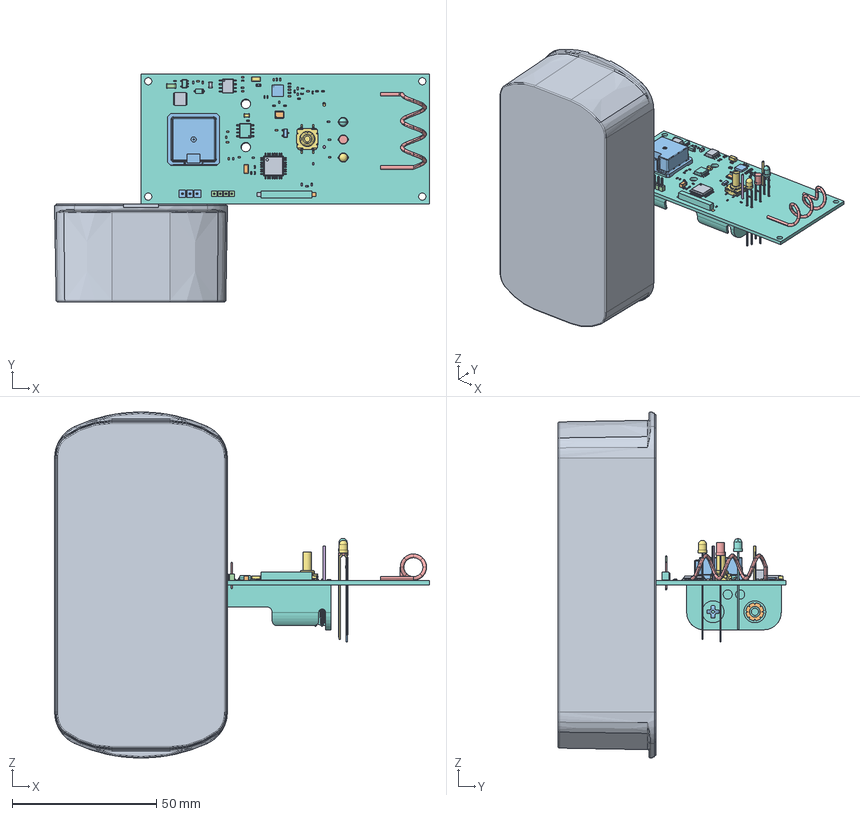
[picture p9: CAD file, 2025-10-16]
mechanical/gateway/gateway.FCStd
130.0 x 79.0 x 119.9 mm
SICB6-12-4_HP用
C_0402_1005Metric
PinsArrayL
PinsArrayL001
FilletPinR
R_0402_1005Metric
PinsArrayLR
PinsArrayLR001
PinsArrayLR002
PinsArrayLR003
PinsArrayLR004
PinsArrayLR005
PinsArrayLR006
PinsArrayLR007
PinsArrayLR009
PinsArrayLR010
PinsArrayLR011
PinsArrayLR012
PinsArrayLR013
PinsArrayLR014
PinsArrayLR015
PinsArrayLR016
C_0402_1005Metric001
C_0402_1005Metric002
R_0402_1005Metric001
C_0402_1005Metric003
R_0402_1005Metric002
C_0402_1005Metric004
C_0402_1005Metric005
PinsArrayLR018
PinsArrayLR019
PinsArrayLR020
PinsArrayLR021
PinsArrayLR022
PinsArrayLR023
PinsArrayLR024
PinsArrayLR025
PinsArrayLR026
PinsArrayLR027
PinsArrayLR028
PinsArrayLR029
PinsArrayLR030
PinsArrayLR031
PinsArrayLR032
PinsArrayLR033
PinsArrayTB
PinsArrayTB001
PinsArrayTB002
PinsArrayTB003
PinsArrayTB004
PinsArrayTB005
PinsArrayTB006
PinsArrayTB007
PinsArrayTB008
PinsArrayTB009
PinsArrayTB010
PinsArrayTB011
PinsArrayTB012
PinsArrayTB013
PinsArrayTB014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
