npeixoto64/ExitGuardian/mechanical/sensor/rev1/CS75-W.stp

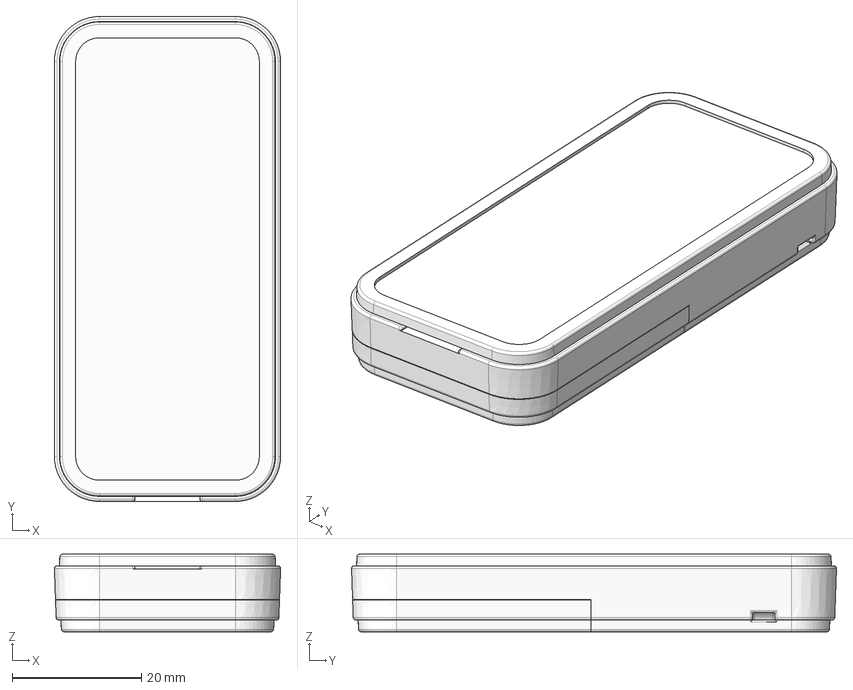
[picture p10: CAD file, 2026-07-28]
mechanical/sensor/rev1/CS75-W.stp
35.0 x 75.0 x 12.0 mm
CS75 bottom cover_R
cs75 top cover(18.8.30)
CS75 battery cover_R_200403
ﾋﾞｽ M1.6×6 x 4
