npeixoto64/ExitGuardian/docs/references/enclosures/sensor/3D/CST-2032P..stp

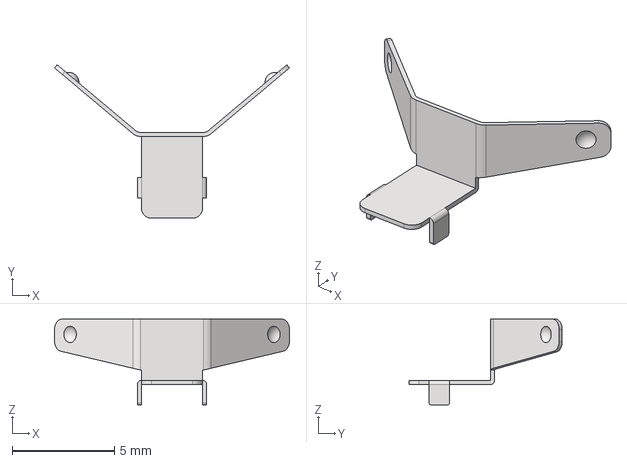
[picture p11: CAD file, 2026-07-28]
docs/references/enclosures/sensor/3D/CST-2032P..stp
11.5 x 7.51 x 4.20 mm
