npeixoto64/ExitGuardian/mechanical/sensor/rev0/sensor.FCStd

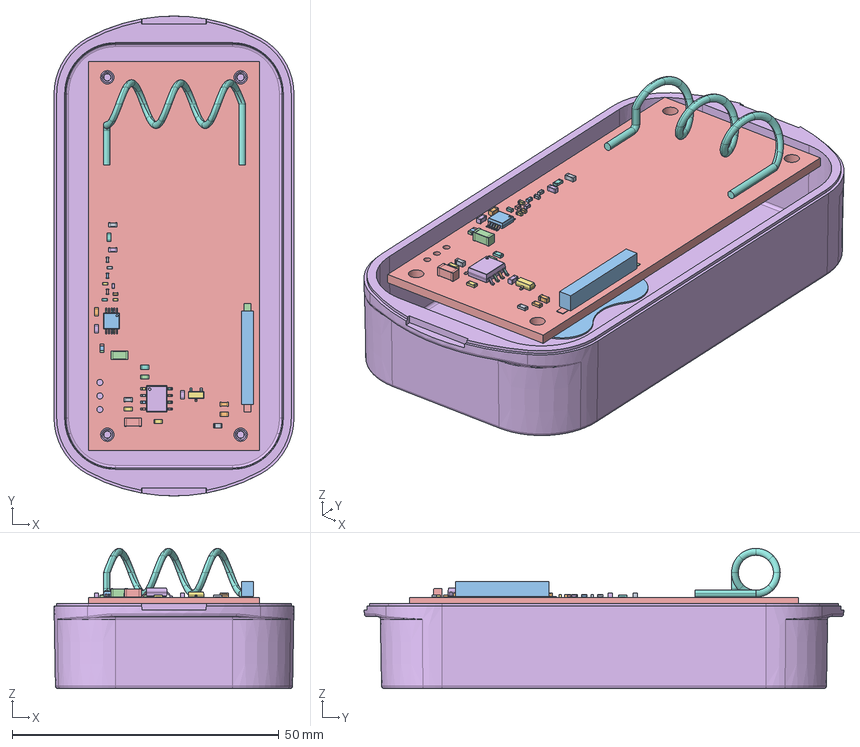
[picture p12: CAD file, 2025-10-09, an earlier design]
mechanical/sensor/rev0/sensor.FCStd
45.0 x 90.0 x 26.3 mm
C_0402_1005Metric
C_0603_1608Metric
Pins
Pins001
PinsArrayLR
PinsArrayLR001
PinsArrayLR002
PinsArrayLR003
PinsArrayLR004
PinsArrayLR005
PinsArrayLR006
PinsArrayLR007
C_0603_1608Metric001
L_0402_1005Metric
R_0603_1608Metric
R_0603_1608Metric001
BLM18KG601SN1D
BLM18KG601SN1D001
BLM18KG601SN1D002
L_0402_1005Metric001
BODY-SOT
LEAD-SOT
LEAD-SOT001
LEAD-SOT002
TIEBAR
R_0603_1608Metric002
C_0402_1005Metric001
C_0603_1608Metric002
R_0603_1608Metric003
ANT-868-HESM
C_0603_1608Metric003
C_0603_1608Metric004
L_0402_1005Metric002
C_1206_3216Metric
C_1206_3216Metric001
C_0603_1608Metric005
C_0402_1005Metric002
R_0603_1608Metric004
C_0603_1608Metric006
C_0402_1005Metric003
PinsArrayLR009
PinsArrayLR010
PinsArrayLR011
PinsArrayLR012
PinsArrayLR013
PinsArrayLR014
PinsArrayLR015
PinsArrayLR016
PinsArrayLR017
PinsArrayLR018
C_0603_1608Metric007
L_0402_1005Metric003
R_0603_1608Metric005
C_0402_1005Metric004
C_0402_1005Metric005
BAT-HLD-006-SMT
L_0603_1608Metric
sensor_PCB
SICB5-9-2_HP用
