npeixoto64/ExitGuardian/mechanical/sensor/rev0/SIC5-9-2W.stp

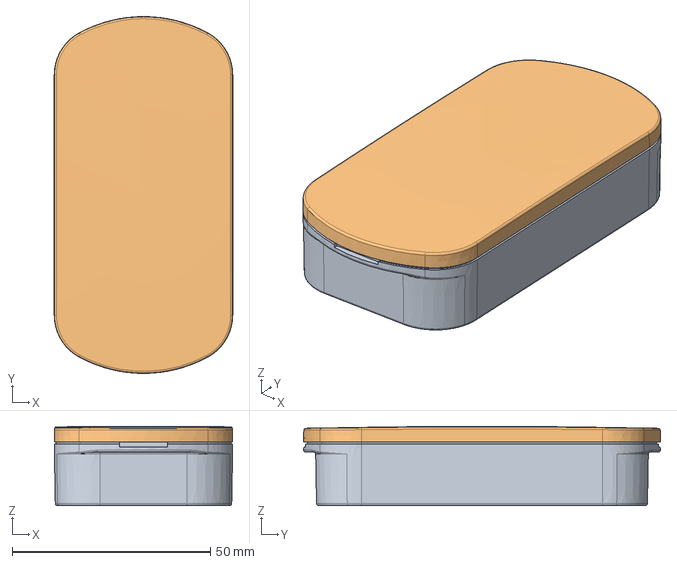
[picture p13: CAD file, 2025-10-09, an earlier design]
mechanical/sensor/rev0/SIC5-9-2W.stp
45.0 x 90.0 x 20.0 mm
4570下カバー_32ブラケット
4570上カバー
