npeixoto64/ExitGuardian/(list of files, cad)

Other CAD files:
hardware/sensor/rev0/output/PCBA/sensor.step
mechanical/gateway/rev2/gateway.FCStd
