npeixoto64/ExitGuardian/hardware/sensor/rev1/sensor_rev1.kicad_pcb

## KiCad design hardware/sensor/rev1/sensor_rev1.kicad_pcb (2026-08-31)

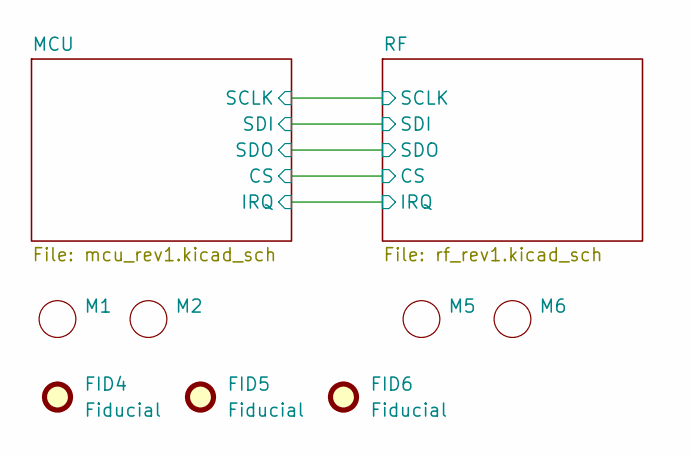
[picture p14: schematic sensor_rev1.kicad_sch, Window Sensor]

Parts:
FID4, FID5, FID6: Fiducial; Fiducial_1mm_Mask2mm
M1, M2, M5, M6: MountingHole_1.7mm

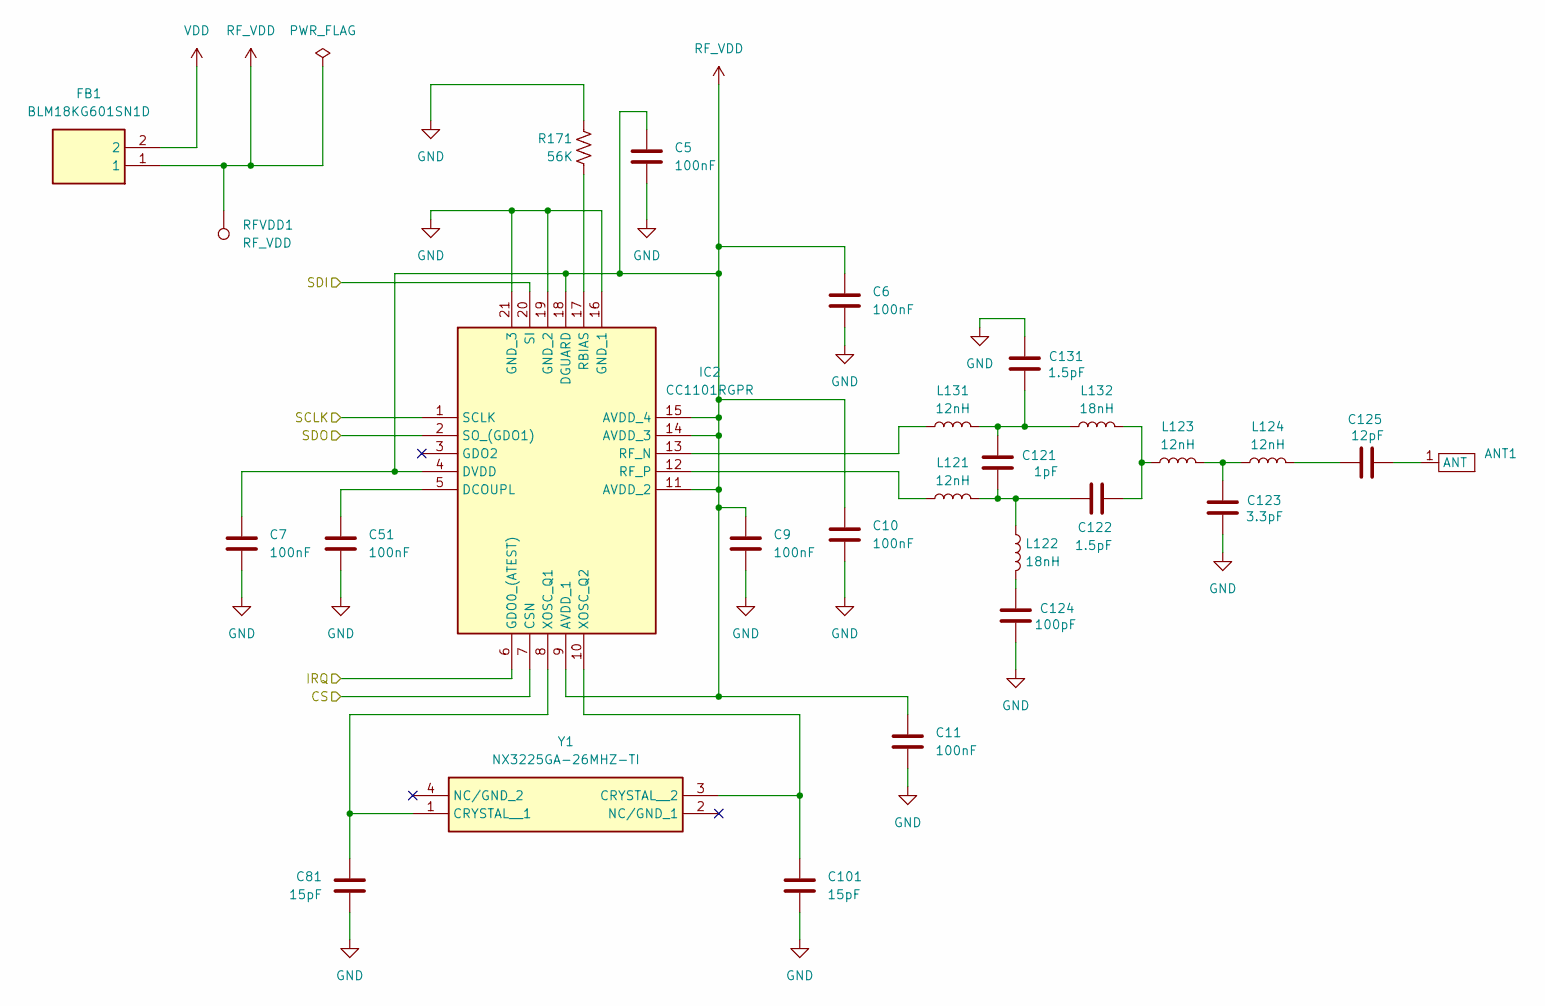
[picture p15: schematic rf_rev1.kicad_sch, RF]

Parts:
ANT1: Antenna_hole
C5, C6, C7, C9, C10, C11, C51: 100nF; C_0402_1005Metric; Mouser Part Number 603-CC402KRX7R7BB104
C81, C101: 15pF; C_0402_1005Metric; Mouser Part Number 77-VJ0402D150FXCAJ
C121: 1pF; C_0402_1005Metric; Mouser Part Number 81-GRM1555C1H1R0BA1J
C122, C131: 1.5pF; C_0402_1005Metric; Mouser Part Number 81-GRM1555C1E1R5BA1D
C123: 3.3pF; C_0402_1005Metric; Mouser Part Number 81-GRM1555C1H3R3WA1D
C124: 100pF; C_0402_1005Metric; Mouser Part Number 81-GRM1555C1H101FA1J
C125: 12pF; C_0402_1005Metric; Mouser Part Number 81-GRM1555C1H120FA1D
FB1: BLM18KG601SN1D; BLM18SP221SN1B; Mouser Part Number 81-BLM18KG601SN1D
IC2: CC1101RGPR; QFN50P400X400X100-21N-D; Mouser Part Number 595-CC1101RGPR
L121, L123, L124, L131: 12nH; L_0402_1005Metric; Mouser Part Number 81-LQW15AN12NJ80D
L122, L132: 18nH; L_0402_1005Metric; Mouser Part Number 81-LQG15HH18NJ02D
R171: 56K; R_0402_1005Metric; Mouser Part Number 667-ERJ-PA2F5602X
RFVDD1: RF_VDD; TestPoint_Pad_D1.0mm
Y1: NX3225GA-26MHZ-TI; NX3225GA26000MSTDCRG2; Mouser Part Number 344-NX3225GA26MHZTI

Connections:
/MCU/CS: IC2.7 (CSN); also elsewhere on the board
/MCU/IRQ: IC2.6 (GDO0_(ATEST)); also elsewhere on the board
/MCU/SCLK: IC2.1 (SCLK); also elsewhere on the board
/MCU/SDI: IC2.20 (SI); also elsewhere on the board
/MCU/SDO: IC2.2 (SO_(GDO1)); also elsewhere on the board
GND: C5.2, C6.2, C7.2, C9.2, C10.2, C11.2, C51.2, C81.2, C101.2, C123.1, C124.1, C131.2, IC2.16 (GND_1), IC2.19 (GND_2), IC2.21 (GND_3), R171.2; also elsewhere on the board
unnamed: ANT1.1 (ANT_1), C125.2
unnamed: C121.1, C122.1, L121.2, L122.1
unnamed: C121.2, C131.1, L131.2, L132.1
unnamed: C122.2, L123.1, L132.2
unnamed: C123.2, L123.2, L124.1
unnamed: C124.2, L122.2
unnamed: C125.1, L124.2
unnamed: C51.1, IC2.5 (DCOUPL)
unnamed: IC2.17 (RBIAS), R171.1
unnamed: IC2.13 (RF_N), L131.1
unnamed: IC2.12 (RF_P), L121.1
unnamed: C81.1, IC2.8 (XOSC_Q1), Y1.1 (CRYSTAL__1)
unnamed: C101.1, IC2.10 (XOSC_Q2), Y1.3 (CRYSTAL__2)
RF_VDD: C5.1, C6.1, C7.1, C9.1, C10.1, C11.1, FB1.1, IC2.4 (DVDD), IC2.9 (AVDD_1), IC2.11 (AVDD_2), IC2.14 (AVDD_3), IC2.15 (AVDD_4), IC2.18 (DGUARD), RFVDD1.1 (1_1)
VDD: FB1.2; also elsewhere on the board

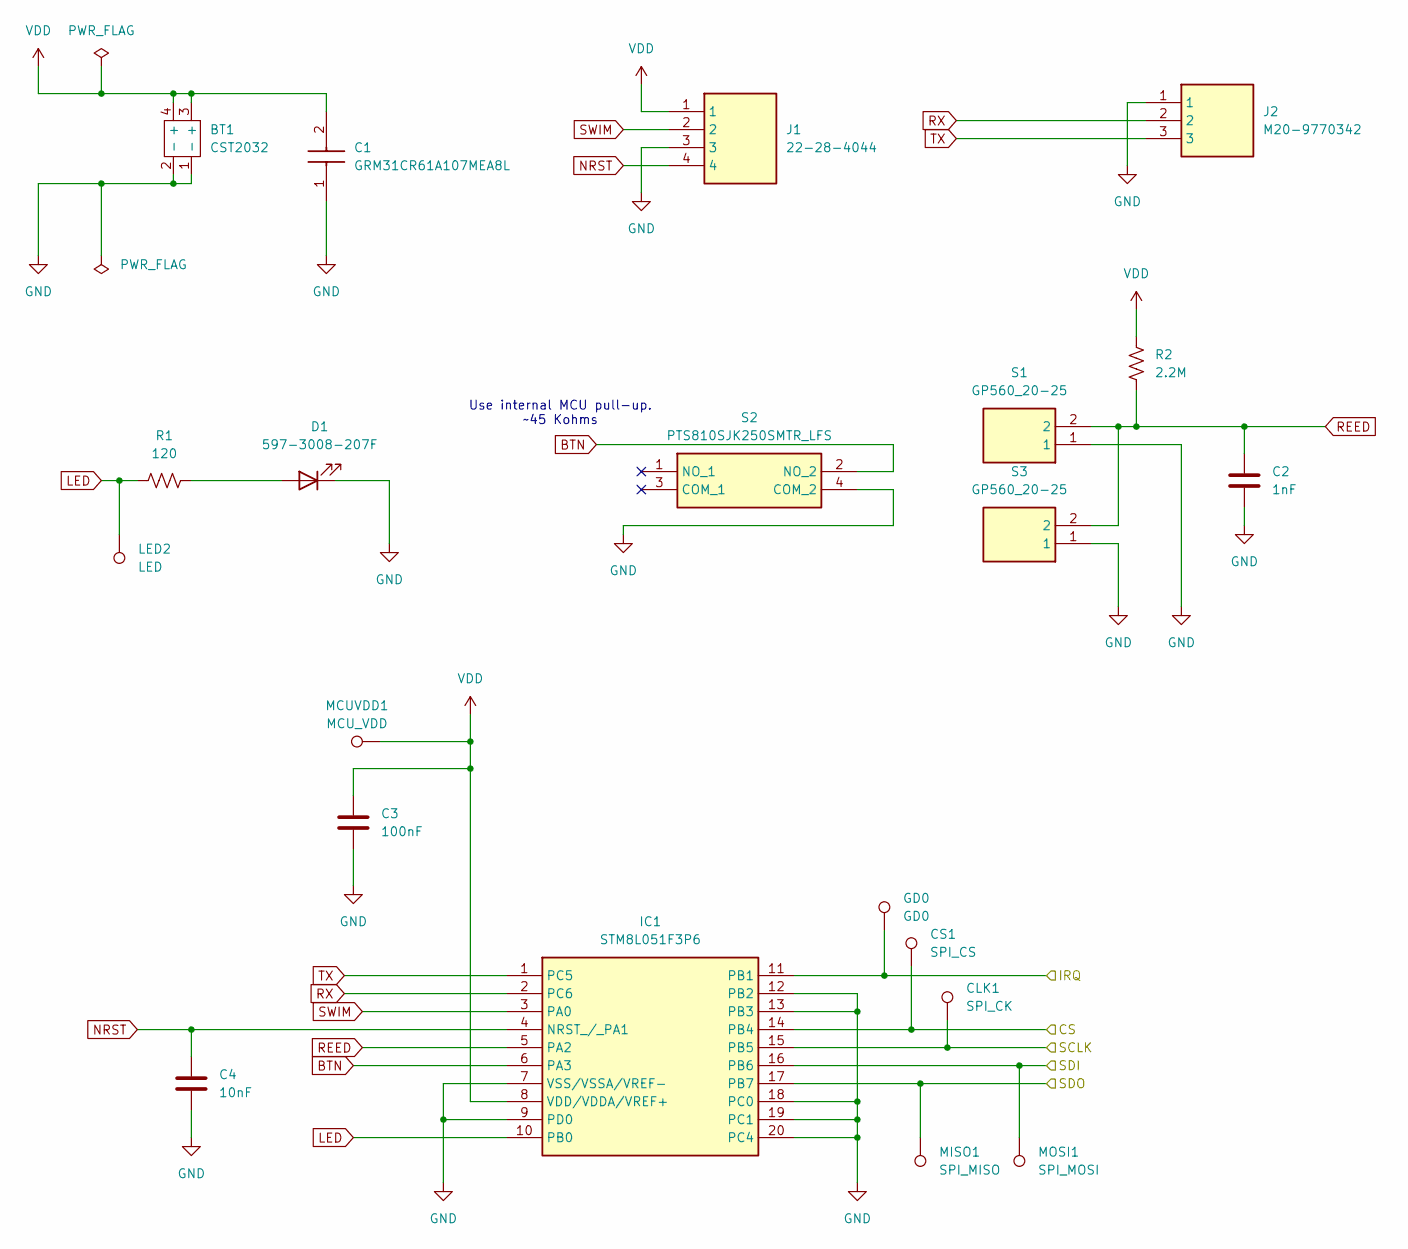
[picture p16: schematic mcu_rev1.kicad_sch, MCU]

Parts:
BT1: CST2032
C1: GRM31CR61A107MEA8L; GRM31x; Mouser Part Number 81-GRM31CR61A107MA8L
C2: 1nF; C_0603_1608Metric; Mouser Part Number 80-C0603C102K8R
C3: 100nF; C_0603_1608Metric; Mouser Part Number 710-885012206020
C4: 10nF; C_0603_1608Metric; Mouser Part Number 603-CC603KRX7R6BB103
CLK1: SPI_CK; TestPoint_Pad_D1.0mm
CS1: SPI_CS; TestPoint_Pad_D1.0mm
D1: 597-3008-207F; 645-597-3008-207F; Mouser Part Number 645-597-3008-207F
GD0: GD0; TestPoint_Pad_D1.0mm
IC1: STM8L051F3P6; SOP65P640X120-20N; Mouser Part Number 511-STM8L051F3P6
J1: 22-28-4044; HDRV4W66P0X254_1X4_1016X249X1067P; Mouser Part Number 538-22-28-4044
J2: M20-9770342; HDRV3W66P0X254_1X3_762X254X855P; Mouser Part Number 855-M20-9770342
LED2: LED; TestPoint_Pad_D1.0mm
MCUVDD1: MCU_VDD; TestPoint_Pad_D1.0mm
MISO1: SPI_MISO; TestPoint_Pad_D1.0mm
MOSI1: SPI_MOSI; TestPoint_Pad_D1.0mm
R1: 120; R_0603_1608Metric; Mouser Part Number 603-RC0603JR-07120RL
R2: 2.2M; R_0603_1608Metric; Mouser Part Number 603-AA0603FR-072M2L
S1, S3: GP560_20-25; GP5602025; Mouser Part Number 876-GP560/20-25
S2: PTS810SJK250SMTR_LFS; PTS810SJK250SMTRLFS; Mouser Part Number 611-PTS810SJK250SMTR

Connections:
/MCU/CS: CS1.1 (1_1), IC1.14 (PB4); also elsewhere on the board
/MCU/IRQ: GD0.1 (1_1), IC1.11 (PB1); also elsewhere on the board
/MCU/SCLK: CLK1.1 (1_1), IC1.15 (PB5); also elsewhere on the board
/MCU/SDI: IC1.16 (PB6), MOSI1.1 (1_1); also elsewhere on the board
/MCU/SDO: IC1.17 (PB7), MISO1.1 (1_1); also elsewhere on the board
BTN: IC1.6 (PA3), S2.2 (NO_2)
GND: BT1.1 (-), BT1.2 (-), C1.1, C2.2, C3.2, C4.2, D1.1 (K), IC1.7 (VSS/VSSA/VREF-), IC1.9 (PD0), IC1.12 (PB2), IC1.13 (PB3), IC1.18 (PC0), IC1.19 (PC1), IC1.20 (PC4), J1.3, J2.1, S1.1, S2.4 (COM_2), S3.1; also elsewhere on the board
LED: IC1.10 (PB0), LED2.1 (1_1), R1.1
NRST: C4.1, IC1.4 (NRST_/_PA1), J1.4
unnamed: D1.2 (A), R1.2
REED: C2.1, IC1.5 (PA2), R2.1, S1.2, S3.2
RX: IC1.2 (PC6), J2.2
SWIM: IC1.3 (PA0), J1.2
TX: IC1.1 (PC5), J2.3
VDD: BT1.3 (+), BT1.4 (+), C1.2, C3.1, IC1.8 (VDD/VDDA/VREF+), J1.1, MCUVDD1.1 (1_1), R2.2; also elsewhere on the board

Notes on the sheet:
Use internal MCU pull-up. ~45 Kohms

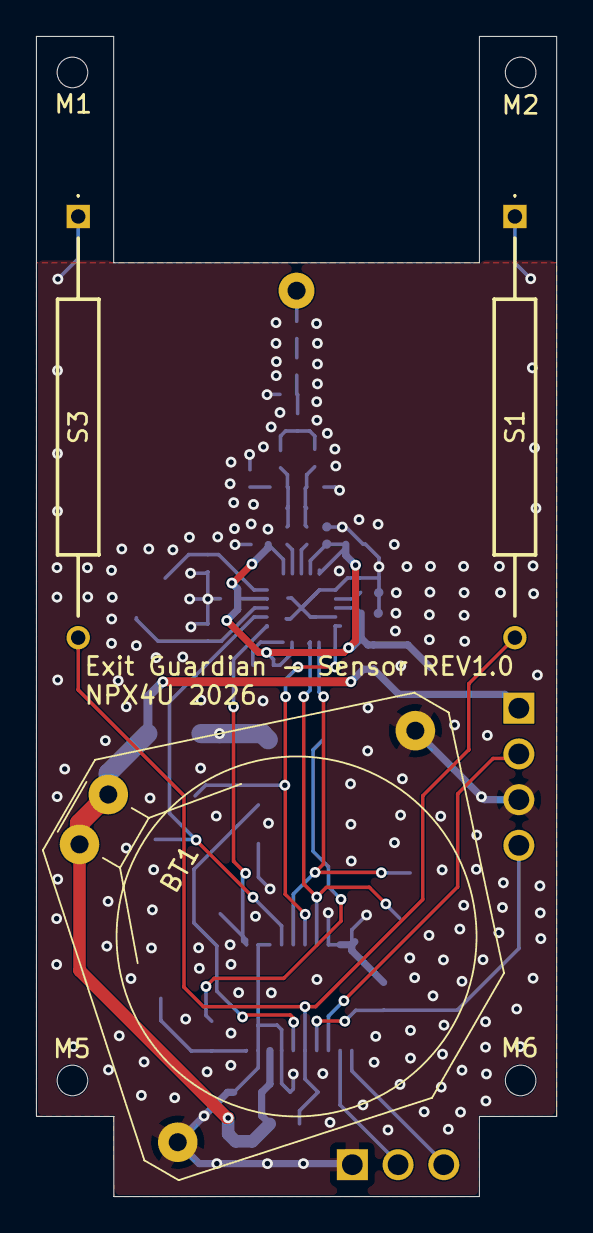
[picture p17: board sensor_rev1.kicad_pcb from above]

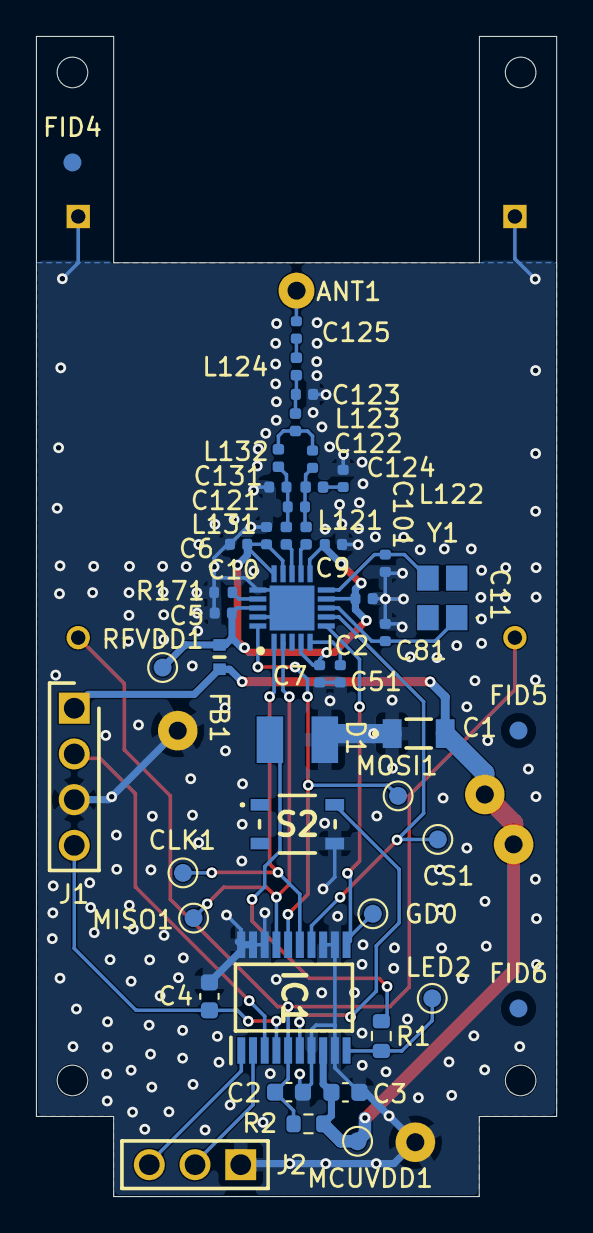
[picture p18: board sensor_rev1.kicad_pcb from below]

Board: 2 copper layers, 28.9 x 64.4 mm, 55 parts (48 on the bottom side), 29 nets.
