npeixoto64/ExitGuardian/hardware/sensor/rev0/sensor.kicad_pcb

## KiCad design hardware/sensor/rev0/sensor.kicad_pcb (2025-10-19, an earlier design)

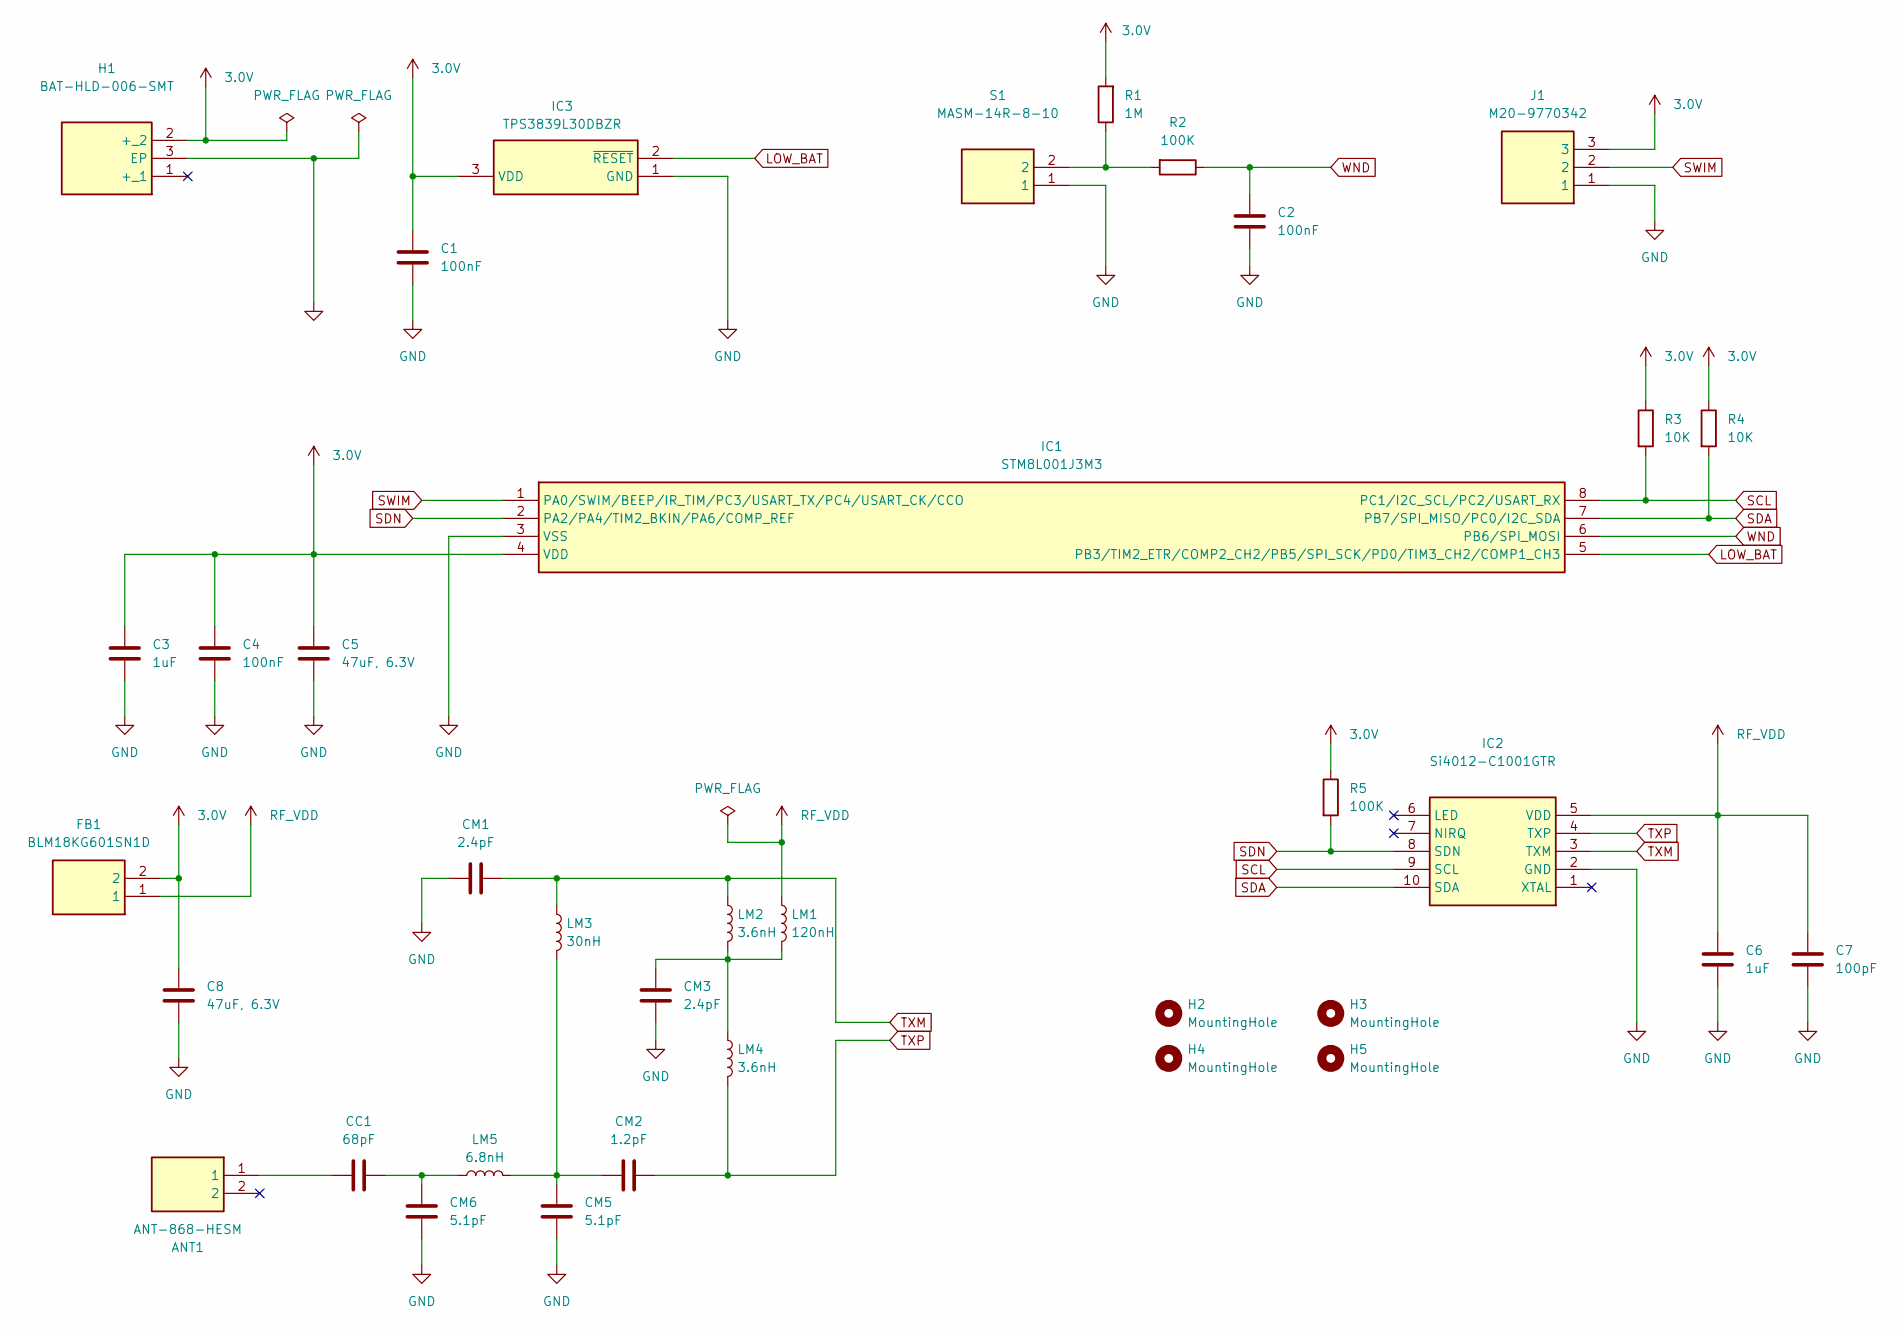
[picture p19: schematic sensor.kicad_sch, Window Sensor]

Parts:
ANT1: ANT-868-HESM; Mouser Part Number 712-ANT-868-HESM
C1, C2, C4: 100nF; C_0603_1608Metric; Mouser Part Number 81-GCJ188R72A104KA1D
C3, C6: 1uF; C_0603_1608Metric; Mouser Part Number 963-MBASE168SB7105KT
C5, C8: 47uF, 6.3V; C_1206_3216Metric; Mouser Part Number 963-JMK325B7476MM-PR
C7: 100pF; C_0603_1608Metric; Mouser Part Number 77-VJ0603Y101MXQCBC
CC1: 68pF; C_0402_1005Metric; Mouser Part Number 81-GRM1555C1H680FA1J
CM1, CM3: 2.4pF; C_0402_1005Metric; Mouser Part Number 81-GRM1555C1H2R4WA1D
CM2: 1.2pF; C_0402_1005Metric; Mouser Part Number 581-04025A1R2DAT2A
CM5, CM6: 5.1pF; C_0402_1005Metric; Mouser Part Number 81-GCQ1555C1H5R1WB1D
FB1: BLM18KG601SN1D; BLM18SP221SN1B; Mouser Part Number 81-BLM18KG601SN1D
H1: BAT-HLD-006-SMT; BATHLD006SMT; Mouser Part Number 712-BAT-HLD-006-SMT
H2, H3, H4, H5: MountingHole; MountingHole_2.5mm
IC1: STM8L001J3M3; SOIC127P600X175-8N; Mouser Part Number 511-STM8L001J3M3
IC2: Si4012-C1001GTR; SOP50P490X110-10N; Mouser Part Number 634-SI4012-C1001GTR
IC3: TPS3839L30DBZR; SOT95P237X112-3N; Mouser Part Number 595-TPS3839L30DBZR
J1: M20-9770342; HDRV3W66P0X254_1X3_762X254X855P; Mouser Part Number 855-M20-9770342
LM1: 120nH; L_0603_1608Metric; Mouser Part Number 0603DC-R12XJRW
LM2, LM4: 3.6nH; L_0402_1005Metric; Mouser Part Number 994-0402HP-3N6XGRW
LM3: 30nH; L_0402_1005Metric; Mouser Part Number 994-0402HP-30NXJRW
LM5: 6.8nH; L_0402_1005Metric; Mouser Part Number 994-0402HP-6N8XGRW
R1: 1M; R_0603_1608Metric; Mouser Part Number 755-SFR03EZPJ105
R2, R5: 100K; R_0603_1608Metric; Mouser Part Number 71-RCA0603100KJNEA
R3, R4: 10K; R_0603_1608Metric; Mouser Part Number 603-AC0603JR-7W10KL
S1: MASM-14R-8-10; MASM14R810; Mouser Part Number 934-MASM-14R-8-10

Connections:
3.0V: C1.1, C3.1, C4.1, C5.1, C8.1, FB1.2, H1.2 (+_2), IC1.4 (VDD), IC3.3 (VDD), J1.3, R1.2, R3.1, R4.1, R5.1
GND: C1.2, C2.2, C3.2, C4.2, C5.2, C6.2, C7.2, C8.2, CM1.2, CM3.2, CM5.2, CM6.2, H1.3 (EP), IC1.3 (VSS), IC2.2 (GND), IC3.1 (GND), J1.1, S1.1
LOW_BAT: IC1.5 (PB3/TIM2_ETR/COMP2_CH2/PB5/SPI_SCK/PD0/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), IC3.2 (~RESET)
unnamed: ANT1.1, CC1.1
unnamed: CC1.2, CM6.1, LM5.1
unnamed: CM2.1, CM5.1, LM3.2, LM5.2
unnamed: CM3.1, LM1.2, LM2.2, LM4.1
unnamed: R1.1, R2.2, S1.2
RF_VDD: C6.1, C7.1, FB1.1, IC2.5 (VDD), LM1.1
SCL: IC1.8 (PC1/I2C_SCL/PC2/USART_RX), IC2.9 (SCL), R3.2
SDA: IC1.7 (PB7/SPI_MISO/PC0/I2C_SDA), IC2.10 (SDA), R4.2
SDN: IC1.2 (PA2/PA4/TIM2_BKIN/PA6/COMP_REF), IC2.8 (SDN), R5.2
SWIM: IC1.1 (PA0/SWIM/BEEP/IR_TIM/PC3/USART_TX/PC4/U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), J1.2
TXM: CM1.1, IC2.3 (TXM), LM2.1, LM3.1
TXP: CM2.2, IC2.4 (TXP), LM4.2
WND: C2.1, IC1.6 (PB6/SPI_MOSI), R2.1

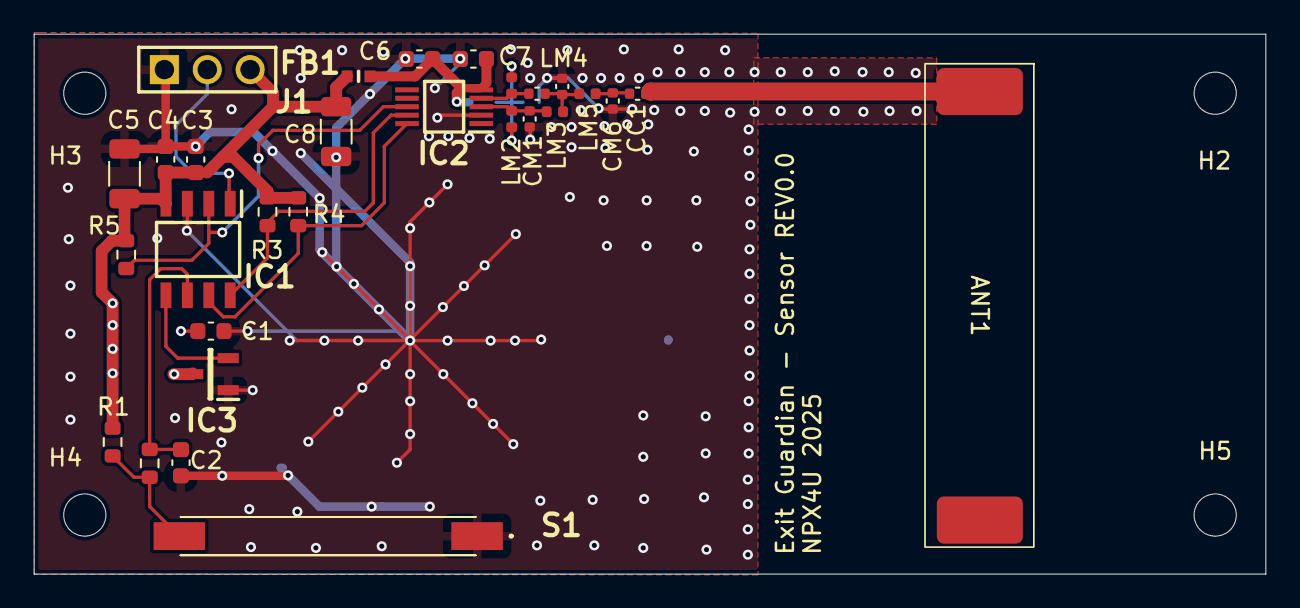
[picture p20: board sensor.kicad_pcb from above]

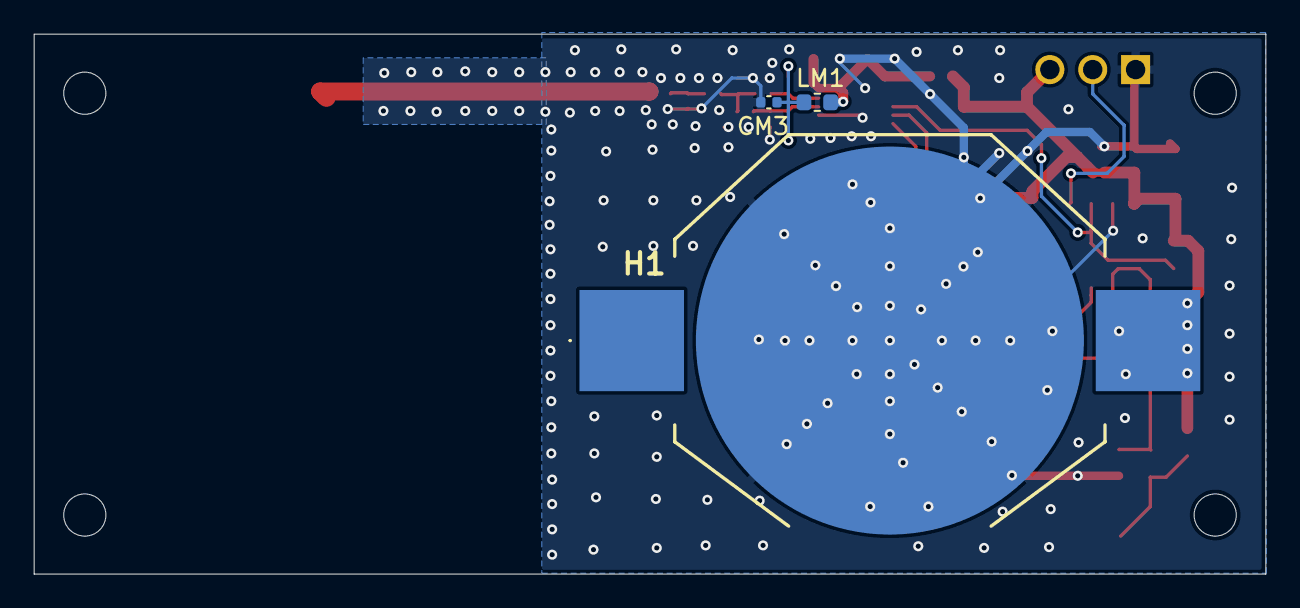
[picture p21: board sensor.kicad_pcb from below]

Board: 2 copper layers, 73.0 x 32.0 mm, 36 parts (3 on the bottom side), 16 nets.
