npeixoto64/ExitGuardian/hardware/gateway/rev1/gateway_rev1.kicad_pcb

## KiCad design hardware/gateway/rev1/gateway_rev1.kicad_pcb (2025-10-21, an earlier design)

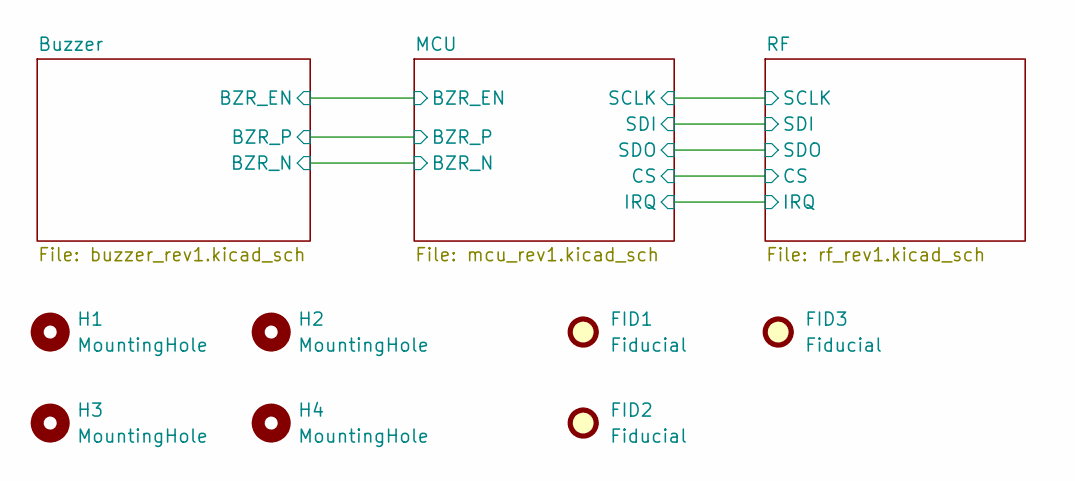
[picture p22: schematic gateway_rev1.kicad_sch, Gateway]

Parts:
FID1, FID2, FID3: Fiducial; Fiducial_1mm_Mask2mm
H1, H2, H3, H4: MountingHole; MountingHole_2.5mm

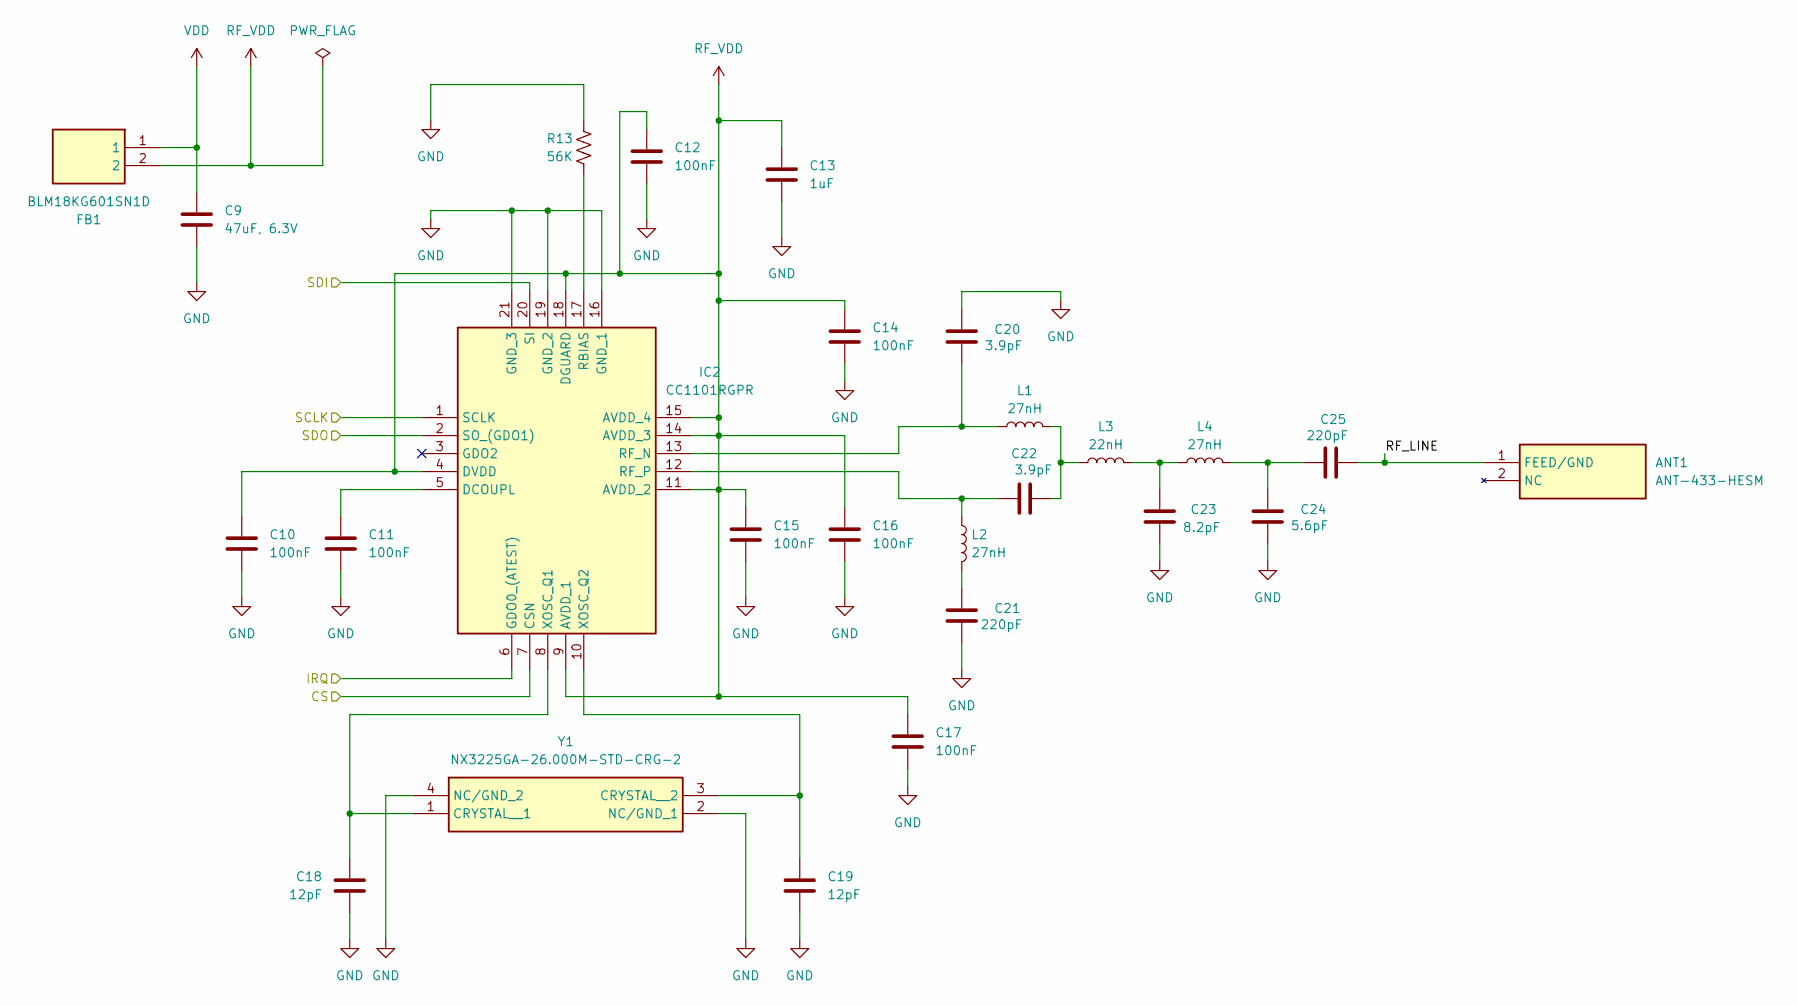
[picture p23: schematic rf_rev1.kicad_sch, RF]

Parts:
ANT1: ANT-433-HESM; ANT433HESM; Mouser Part Number 712-ANT-433-HESM
C9: 47uF, 6.3V; C_1206_3216Metric; Mouser Part Number 963-JMK325B7476MM-PR
C10, C11, C12, C14, C15, C16, C17: 100nF; C_0402_1005Metric; Mouser Part Number 603-CC402KRX7R7BB104
C13: 1uF; C_0402_1005Metric; Mouser Part Number 81-GXT155R60J105KE1D
C18, C19: 12pF; C_0402_1005Metric; Mouser Part Number 81-GRM1555C1H120FA1D
C20, C22: 3.9pF; C_0402_1005Metric; Mouser Part Number 81-GRM1555C1E3R9CA1D
C21, C25: 220pF; C_0402_1005Metric; Mouser Part Number 81-GRM0225C1C221JA2L
C23: 8.2pF; C_0402_1005Metric; Mouser Part Number 81-GCQ0335C1H8R2WB1D
C24: 5.6pF; C_0402_1005Metric; Mouser Part Number 81-GCQ0335C1H5R6BB1D
FB1: BLM18KG601SN1D; BLM18SP221SN1B; Mouser Part Number 81-BLM18KG601SN1D
IC2: CC1101RGPR; QFN50P400X400X100-21N-D; Mouser Part Number 595-CC1101RGPR
L1, L2, L4: 27nH; L_0402_1005Metric; Mouser Part Number 81-LQG15HS27NJ02D
L3: 22nH; L_0402_1005Metric; Mouser Part Number 81-LQW15CA22NJ00D
R13: 56K; R_0402_1005Metric; Mouser Part Number 667-ERJ-PA2F5602X
Y1: NX3225GA-26.000M-STD-CRG-2; NX3225GA26000MSTDCRG2; Mouser Part Number 344-NX3225GA26MSTRG2

Connections:
/MCU/CS: IC2.7 (CSN); also elsewhere on the board
/MCU/IRQ: IC2.6 (GDO0_(ATEST)); also elsewhere on the board
/MCU/SCLK: IC2.1 (SCLK); also elsewhere on the board
/MCU/SDI: IC2.20 (SI); also elsewhere on the board
/MCU/SDO: IC2.2 (SO_(GDO1)); also elsewhere on the board
/RF/RF_LINE: ANT1.1 (FEED/GND), C25.2
GND: C9.2, C10.2, C11.2, C12.2, C13.2, C14.2, C15.2, C16.2, C17.2, C18.2, C19.2, C20.2, C21.1, C23.1, C24.1, IC2.16 (GND_1), IC2.19 (GND_2), IC2.21 (GND_3), R13.2, Y1.2 (NC/GND_1), Y1.4 (NC/GND_2); also elsewhere on the board
unnamed: C21.2, L2.2
unnamed: C22.1, L1.2, L3.1
unnamed: C23.2, L3.2, L4.1
unnamed: C24.2, C25.1, L4.2
unnamed: C11.1, IC2.5 (DCOUPL)
unnamed: IC2.17 (RBIAS), R13.1
unnamed: C20.1, IC2.13 (RF_N), L1.1
unnamed: C22.2, IC2.12 (RF_P), L2.1
unnamed: C18.1, IC2.8 (XOSC_Q1), Y1.1 (CRYSTAL__1)
unnamed: C19.1, IC2.10 (XOSC_Q2), Y1.3 (CRYSTAL__2)
RF_VDD: C10.1, C12.1, C13.1, C14.1, C15.1, C16.1, C17.1, FB1.2, IC2.4 (DVDD), IC2.9 (AVDD_1), IC2.11 (AVDD_2), IC2.14 (AVDD_3), IC2.15 (AVDD_4), IC2.18 (DGUARD)
VDD: C9.1, FB1.1; also elsewhere on the board

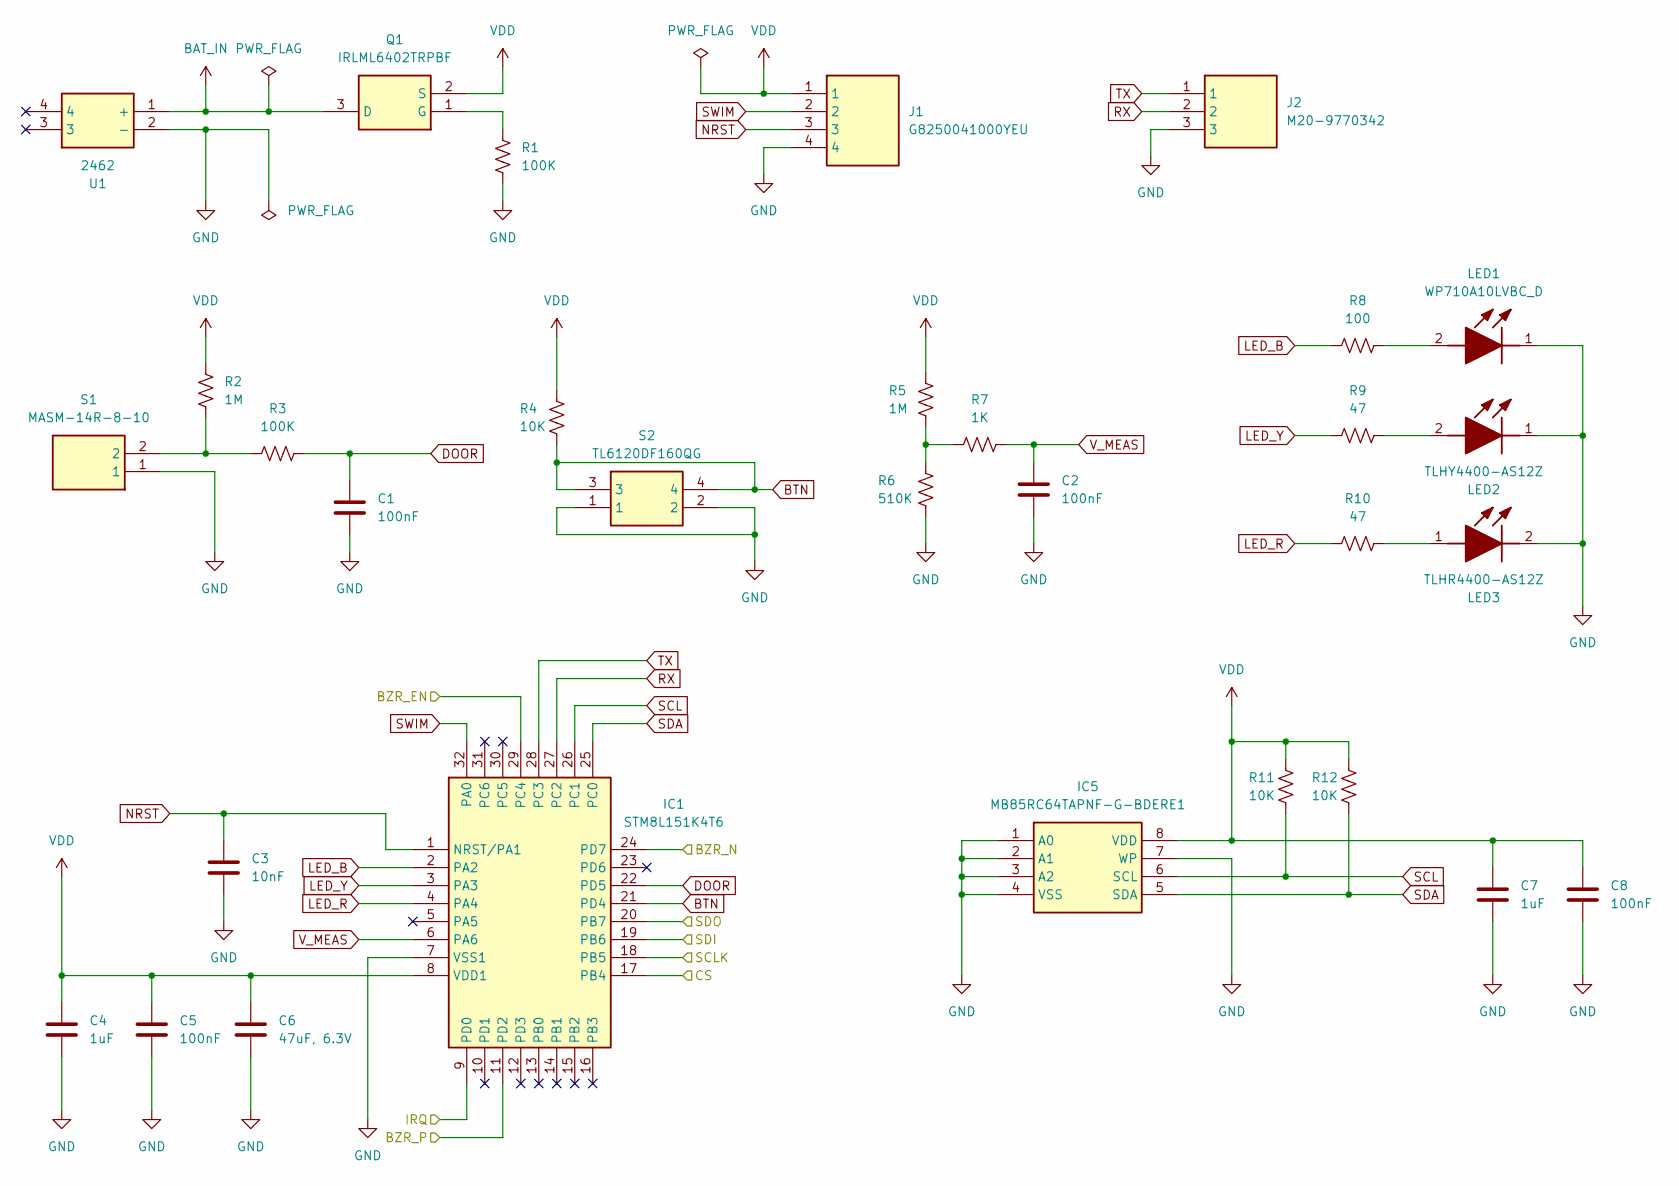
[picture p24: schematic mcu_rev1.kicad_sch, MCU]

Parts:
C1, C2, C5: 100nF; C_0603_1608Metric; Mouser Part Number 963-MAJCH168BB7104KT
C3: 10nF; C_0402_1005Metric; Mouser Part Number 81-GXT155R71C103KE1D
C4: 1uF; C_0603_1608Metric; Mouser Part Number 603-CC603KRX5R6BB105
C6: 47uF, 6.3V; C_1206_3216Metric; Mouser Part Number 963-JMK325B7476MM-PR
C7: 1uF; C_0402_1005Metric; Mouser Part Number 81-GXT155R60J105KE1D
C8: 100nF; C_0402_1005Metric; Mouser Part Number 603-CC402KRX7R7BB104
IC1: STM8L151K4T6; QFP80P900X900X160-32N; Mouser Part Number 511-STM8L151K4T6
IC5: MB85RC64TAPNF-G-BDERE1; SOIC127P602X173-8N; Mouser Part Number 249-85C64TAPNFGBDR1
J1: G8250041000YEU; HDRV4W55P0X200_1X4_800X200X635P; Mouser Part Number 523-G8250041000YEU
J2: M20-9770342; HDRV3W66P0X254_1X3_762X254X855P; Mouser Part Number 855-M20-9770342
LED1: WP710A10LVBC_D; WP710A10LVBCD; Mouser Part Number 604-WP710A10LVBCD
LED2: TLHY4400-AS12Z; TLHY4400AS12Z; Mouser Part Number 78-TLHY4400-AS12Z
LED3: TLHR4400-AS12Z; TLHR4400AS12Z; Mouser Part Number 78-TLHR4400-AS12Z
Q1: IRLML6402TRPBF; SOT95P237X112-3N; Mouser Part Number 942-IRLML6402TRPBF
R1, R3: 100K; R_0603_1608Metric; Mouser Part Number 594-MCT06030C1003FP5
R2, R5: 1M; R_0603_1608Metric; Mouser Part Number 603-AR0603FR-071ML
R4, R11, R12: 10K; R_0603_1608Metric; Mouser Part Number 71-RCA060310K0JNEA
R6: 510K; R_0603_1608Metric; Mouser Part Number 71-CRCW0603-510K
R7: 1K; R_0603_1608Metric; Mouser Part Number 603-SR0603JR-071KL
R8: 100; R_0603_1608Metric; Mouser Part Number 71-CRCW0603100RJNEBC
R9, R10: 47; R_0603_1608Metric; Mouser Part Number 667-ERJ-S03J470V
S1: MASM-14R-8-10; MASM14R810; Mouser Part Number 934-MASM-14R-8-10
S2: TL6120DF160QG; Mouser Part Number 612-TL6120DF160QG
U1: 2462; Mouser Part Number 534-2462

Connections:
/Buzzer/BZR_EN: IC1.29 (PC4); also elsewhere on the board
/Buzzer/BZR_N: IC1.24 (PD7); also elsewhere on the board
/Buzzer/BZR_P: IC1.11 (PD2); also elsewhere on the board
/MCU/CS: IC1.17 (PB4); also elsewhere on the board
/MCU/IRQ: IC1.9 (PD0); also elsewhere on the board
/MCU/SCLK: IC1.18 (PB5); also elsewhere on the board
/MCU/SDI: IC1.19 (PB6); also elsewhere on the board
/MCU/SDO: IC1.20 (PB7); also elsewhere on the board
BAT_IN: Q1.3 (D), U1.1 (+)
BTN: IC1.21 (PD4), R4.1, S2.3, S2.4
DOOR: C1.1, IC1.22 (PD5), R3.2
GND: C1.2, C2.2, C3.2, C4.2, C5.2, C6.2, C7.2, C8.2, IC1.7 (VSS1), IC5.1 (A0), IC5.2 (A1), IC5.3 (A2), IC5.4 (VSS), IC5.7 (WP), J1.4, J2.3, LED1.1 (K), LED2.1 (K), LED3.2 (K), R1.2, R6.1, S1.1, S2.1, S2.2, U1.2 (-); also elsewhere on the board
LED_B: IC1.2 (PA2), R8.1
LED_R: IC1.4 (PA4), R10.1
LED_Y: IC1.3 (PA3), R9.1
NRST: C3.1, IC1.1 (NRST/PA1), J1.3
unnamed: LED1.2 (A), R8.2
unnamed: LED2.2 (A), R9.2
unnamed: LED3.1 (A), R10.2
unnamed: Q1.1 (G), R1.1
unnamed: R2.1, R3.1, S1.2
unnamed: R5.1, R6.2, R7.1
RX: IC1.27 (PC2), J2.2
SCL: IC1.26 (PC1), IC5.6 (SCL), R11.1
SDA: IC1.25 (PC0), IC5.5 (SDA), R12.1
SWIM: IC1.32 (PA0), J1.2
TX: IC1.28 (PC3), J2.1
VDD: C4.1, C5.1, C6.1, C7.1, C8.1, IC1.8 (VDD1), IC5.8 (VDD), J1.1, Q1.2 (S), R2.2, R4.2, R5.2, R11.2, R12.2; also elsewhere on the board
V_MEAS: C2.1, IC1.6 (PA6), R7.2
