npeixoto64/ExitGuardian/hardware/gateway/rev1/gateway_rev1.kicad_pcb

## KiCad design hardware/gateway/rev1/gateway_rev1.kicad_pcb (continued)

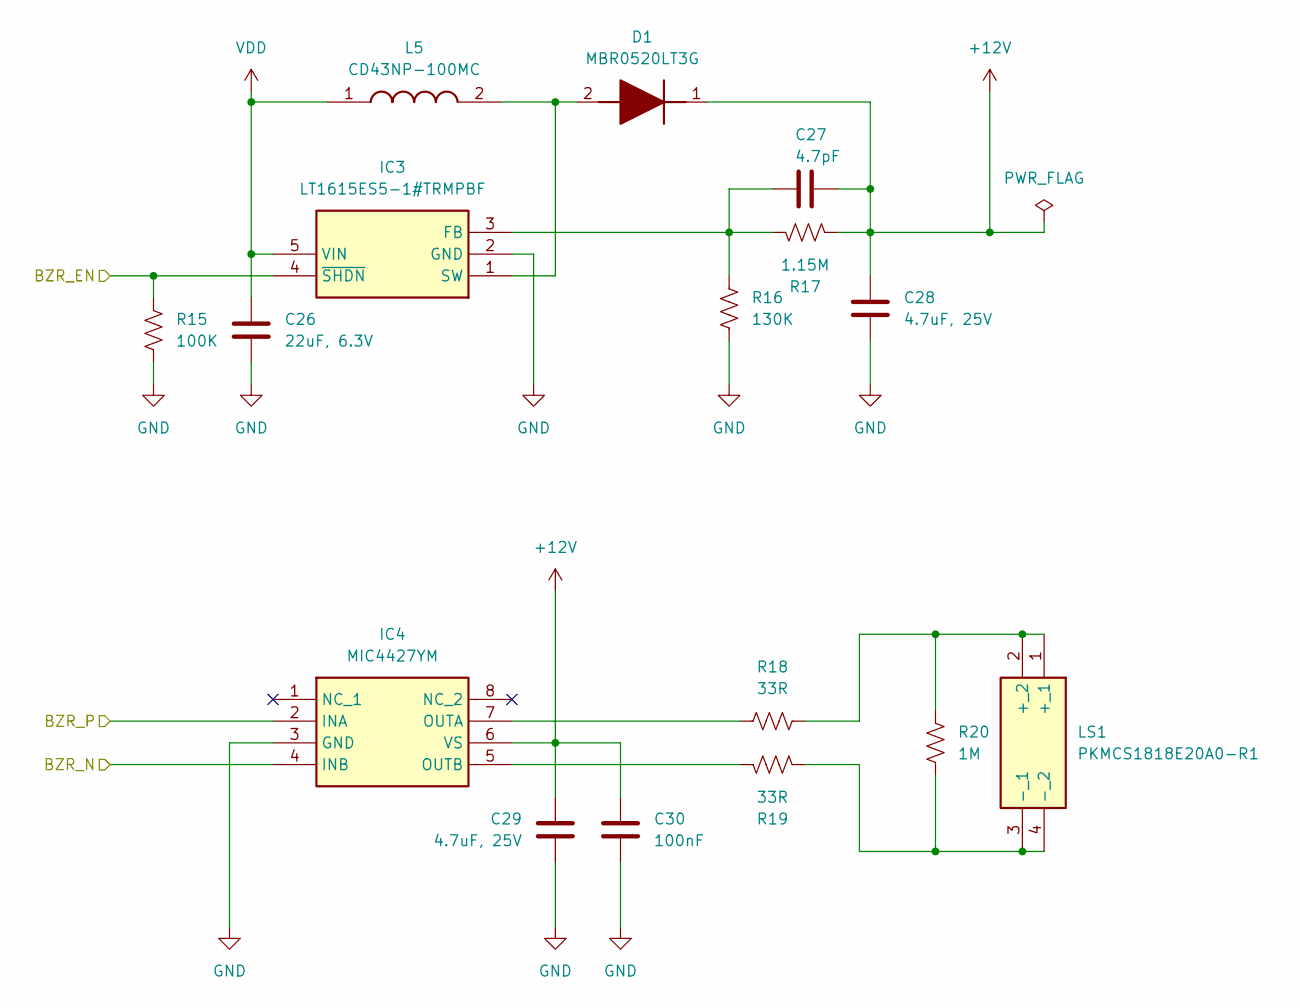
[picture p25: schematic buzzer_rev1.kicad_sch, Buzzer]

Parts:
C26: 22uF, 6.3V; C_1206_3216Metric; Mouser Part Number 81-GGM31CD70J226KE2L
C27: 4.7pF; C_0402_1005Metric; Mouser Part Number 81-GCM1555C2A4R7BE2D
C28, C29: 4.7uF, 25V; C_0805_2012Metric; Mouser Part Number 963-MCAST21GBC7475KT
C30: 100nF; C_0402_1005Metric; Mouser Part Number 603-CC402KRX7R7BB104
D1: MBR0520LT3G; SOD3716X135N; Mouser Part Number 863-MBR0520LT3G
IC3: LT1615ES5-1#TRMPBF; SOT95P280X100-5N; Mouser Part Number 584-1615ES5-1TRMPBF
IC4: MIC4427YM; SOIC127P599X173-8N; Mouser Part Number 998-MIC4427YM
L5: CD43NP-100MC; CD43NP100MC; Mouser Part Number 851-CD43NP-100MC
LS1: PKMCS1818E20A0-R1; PKMCS1818E20A0R1; Mouser Part Number 81-PKMCS1818E20A0-R1
R15: 100K; R_0603_1608Metric; Mouser Part Number 594-MCT06030C1003FP5
R16: 130K; R_0402_1005Metric; Mouser Part Number 603-RC0402DR-07130KL
R17: 1.15M; R_0402_1005Metric; Mouser Part Number 603-RC0402FR-071M15L
R18, R19: 33R; R_0603_1608Metric; Mouser Part Number 603-SR0603JR-7T33RL
R20: 1M; R_0603_1608Metric; Mouser Part Number 603-AR0603FR-071ML

Connections:
+12V: C27.1, C28.1, C29.1, C30.1, D1.1 (K), IC4.6 (VS), R17.2
/Buzzer/BZR_EN: IC3.4 (~SHDN), R15.2; also elsewhere on the board
/Buzzer/BZR_N: IC4.4 (INB); also elsewhere on the board
/Buzzer/BZR_P: IC4.2 (INA); also elsewhere on the board
GND: C26.2, C28.2, C29.2, C30.2, IC3.2 (GND), IC4.3 (GND), R15.1, R16.1; also elsewhere on the board
unnamed: D1.2 (A), IC3.1 (SW), L5.2
unnamed: C27.2, IC3.3 (FB), R16.2, R17.1
unnamed: IC4.7 (OUTA), R18.2
unnamed: IC4.5 (OUTB), R19.2
unnamed: LS1.1 (+_1), LS1.2 (+_2), R18.1, R20.2
unnamed: LS1.3 (-_1), LS1.4 (-_2), R19.1, R20.1
VDD: C26.1, IC3.5 (VIN), L5.1; also elsewhere on the board

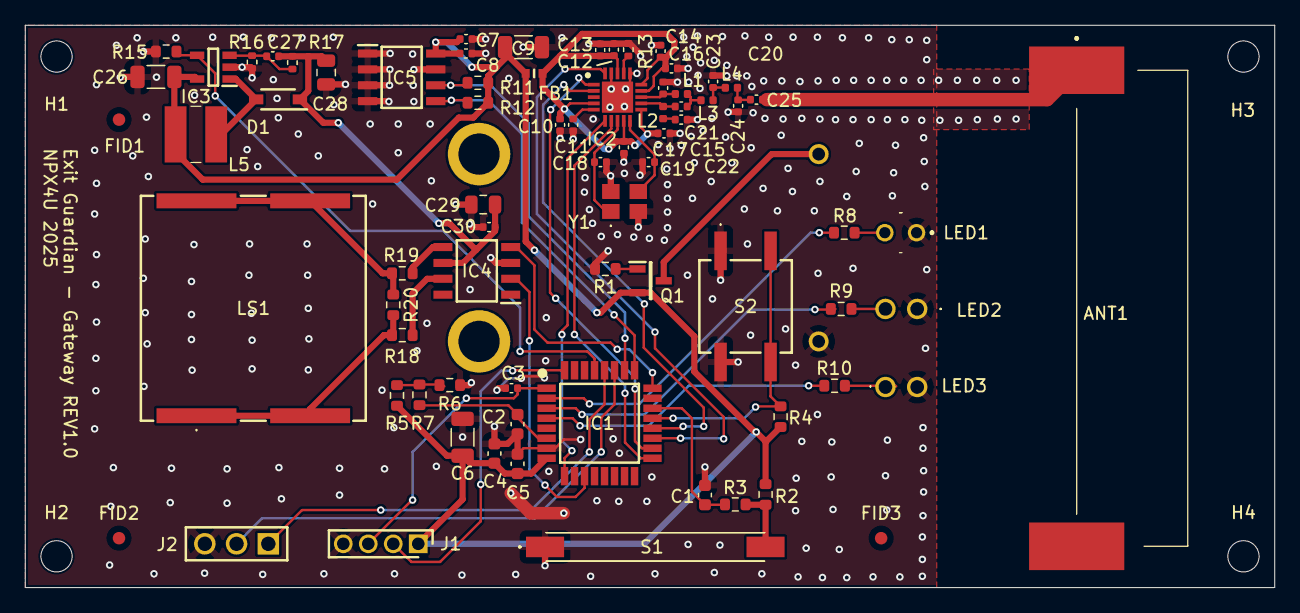
[picture p26: board gateway_rev1.kicad_pcb from above]

Board: 2 copper layers, 100.0 x 45.0 mm, 80 parts (1 on the bottom side), 48 nets.
