npeixoto64/ExitGuardian/(commit log)

2025-09-10 EG-26 Initial Project Setup
    [funding_log.csv, spend_log.csv]
2025-09-11 EG-23 Final review, adding the state remove-sensors.
2025-09-16 EG-23 Removed contradiction regarding the unpairing sensors and factory reset.
2025-09-17 EG-24 Fixed the supply to external 5V DC instead of 230V AC.
2025-09-18 EG-21 KiCad project creation.
    [sensor.kicad_pcb, sensor.kicad_sch]
2025-09-19 EG-21 MCU on schematic.
    [sensor.kicad_pcb, sensor.kicad_sch]
2025-09-19 EG-21 Added datasheets and the main ICs to KiCad project library, including symbol, footprint and 3D model.
    [sensor.kicad_pcb, sensor.kicad_sch]
2025-09-22 EG-28 Sensor will use an MCU and firmware.
2025-09-22 EG-21 Main components on schematic. Only missing I2C resistors, antenna, MCU RESET signal handling and signals MCU<->Si4012.
    [sensor.kicad_pcb, sensor.kicad_sch]
2025-09-23 EG-21 Added all components except the antenna balun and antenna footprint. Added the Si4012 antenna application note.
    [sensor.kicad_sch]
2025-09-23 EG-21 Antenna and programming headers added. Missing the balun part and test points.
    [sensor.kicad_pcb, sensor.kicad_sch]
2025-09-24 EG-21 Balun, pi-matching and antenna connected.
    [sensor.kicad_pcb, sensor.kicad_sch]
2025-09-25 EG-21 Schematic complete, without ERC errors. All components updated in the PCB.
    [sensor.kicad_pcb, sensor.kicad_sch]
2025-09-25 EG-21 All components information inserted. BOM generated.
    [sensor.kicad_sch, sensor_BOM.csv]
2025-09-25 EG-22 Components added to the PCB, no connections, not final position.
    [sensor.kicad_pcb]
2025-09-25 EG-22 DRC configuration for Eurocircuits.
    [sensor.kicad_pcb]
2025-09-25 EG-22 Major (bigger) components placed. Missing the balun and antenna pi-matching circuit.
    [sensor.kicad_pcb]
2025-09-26 EG-22 All components placed, battery counter yard changed. No connections, and not final places for all components.
    [sensor.kicad_pcb, sensor.kicad_sch]
2025-09-28 EG-22 All components places frozen. No connections yet.
    [sensor.kicad_pcb, sensor.kicad_sch, sensor_BOM.csv]
2025-09-28 EG-22 All Components connected, except ground and VDD, RF_VDD planes and CPWG to antenna.
    [sensor.kicad_pcb, sensor.kicad_sch]
2025-09-29 EG-22 All connections, including antenna path and ground planes. Only vias are missing between groud planes.
    [sensor.kicad_pcb, sensor.kicad_sch, sensor_BOM.csv]
2025-09-29 EG-22 All vias placed.
    [sensor.kicad_pcb]
2025-09-30 EG-11 Addded the KiCad project for gateway, with the main components added to library and refasctored the datasheets folder.
    [gateway.kicad_pcb, gateway.kicad_sch]
2025-09-30 EG-11 Preliminary BOM defined on design decisions.
2025-10-02 EG-11 Polarity inversion, MCU in and out interfaces connected, including buzzer driver circuit.
    [buzzer.kicad_sch, gateway.kicad_sch, mcu.kicad_sch, rf.kicad_sch, untitled.kicad_sch]
2025-10-03 EG-11 All components connected in all sheets. The MCU pin mapping needs to be fixed. The BOM needs to be created. The FRAM need needs to be assessed.
    [CC1101_CC1190EM_869MHz_PARTLIST_2_1_0.xls, buzzer.kicad_sch, gateway.kicad_sch, mcu.kicad_sch, rf.kicad_sch]
2025-10-03 EG-11 FRAM included, MCU pin mapping finished. Only BOM is not finished.
    [gateway.kicad_sch, mcu.kicad_sch]
2025-10-04 EG-11 Changed the MCU from ATtiny to STML8 due to minimum supply voltage.
    [mcu.kicad_sch]
2025-10-05 EG-11 All connections finished. BOM not created yet.
    [mcu.kicad_sch]
2025-10-06 EG-11 BOM generated.
    [buzzer.kicad_sch, gateway_BOM.csv, mcu.kicad_sch, rf.kicad_sch]
2025-10-06 EG-11 ERC passed.
    [buzzer.kicad_sch, mcu.kicad_sch, rf.kicad_sch]
2025-10-07 EG-29 MCU changed on schematic.
    [sensor.kicad_pcb, sensor.kicad_sch, sensor_BOM.csv]
2025-10-07 EG-29 MCU changed on PCB and antenna distance fixed.
    [sensor.kicad_pcb, sensor.kicad_sch]
2025-10-07 EG-32 Sensor box found and version updated on PCB silk screen.
    [sensor.kicad_pcb]
2025-10-07 EG-12 Components placed without connections. Balun components place needs to be fixed.
    [gateway.kicad_pcb, rf.kicad_sch]
2025-10-08 EG-12 Adaption of components places.
    [gateway.kicad_pcb]
2025-10-08 EG-32 Silk screen changed and box sizes added to design decisions file.
    [sensor.kicad_pcb]
2025-10-09 EG-12 Options for gateway enclosure.
2025-10-09 EG-32 Adapted the sensor PCB for SIC5-9-2W enclosure, mainly place the holes and adjust the size of the PCB.
    [sensor.kicad_pcb, sensor.kicad_sch]
2025-10-09 EG-32 Added the FreeCad project with only the PCB.
    [sensor.FCStd, sensor.step]
2025-10-09 EG-32 3D model of the enclosure with the PCB inside.
    [SIC5-9-2W.stp, sensor.FCStd, sensor.kicad_pcb, sensor.step]
2025-10-10 EG-12 All components placed. RF connected, except antenna. Buzzer connected, buzzer power supply connected, FRAM connected. Majority os MCU connections missing.
    [buzzer.kicad_sch, gateway.kicad_pcb, gateway.kicad_sch, gateway_BOM.csv, mcu.kicad_sch, rf.kicad_sch]
2025-10-14 EG-12 All components connected, except antenna and ground plane.
    [gateway.kicad_pcb, gateway_BOM.csv, mcu.kicad_sch]
2025-10-14 EG-12 GND disconnected and ground plane created. Still changes to be done on power lines and GND.
    [gateway.kicad_pcb]
2025-10-15 EG-12 Fixes on SPI signals and ground planes. Antenna connected with Coplanar wavelenght. Only missing vias to connect grounds and run the DRC.
    [gateway.kicad_pcb]
2025-10-15 EG-12 All DRC erros and warnings fixed. Only missing the vias connecting the ground planes.
    [gateway.kicad_pcb]
2025-10-15 EG-12 Vias inserted to connecvt both ground planes (top and bottom). No DRC errors. All done.
    [gateway.kicad_pcb]
2025-10-16 EG-31 Project with the electronics enclosure and PCB on FreeCad.
    [SIC6-12-4W.stp, gateway.FCStd, gateway.kicad_pcb]
2025-10-16 EG-34 PCB antenna PI removed and added vias to connect ground planes on battery holder place.
    [sensor.kicad_pcb, sensor.kicad_sch, sensor.step, sensor_BOM.csv]
2025-10-16 EG-33 Added the revision and name of the board on silkscreen.
    [gateway.kicad_pcb]
2025-10-16 EG-34 Fixed the revision and PCB name on silkscreen.
    [sensor.kicad_pcb, sensor.step]
2025-10-16 EG-37 Gerbers, drills, position and BOM generated.
    [sensor.kicad_pcb, sensor.step, sensor_BOM.csv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]
2025-10-16 EG-27 Some RF passive components replaced due to lack of stock. BOM updated.
    [sensor.kicad_sch, sensor.step, sensor_BOM.csv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]
2025-10-17 EG-37 BOM and gerbers generated due to components replacement.
    [sensor.kicad_sch, sensor.step, sensor_BOM.csv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]
2025-10-17 EG-37 Gerbers, BOM and CPL reviewed.
    [sensor.kicad_sch, sensor_BOM.csv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]
2025-10-19 EG-38 Changed the output fabrics location.
    [gateway_BOM.csv]
2025-10-19 EG-38 Replaced all BOM field names to proper ones, according with manufacturer standards.
    [buzzer.kicad_sch, gateway.kicad_pcb, gateway_BOM.csv, mcu.kicad_sch, rf.kicad_sch, sensor.kicad_pcb]
2025-10-19 EG-38 BOM fixed: Choosed the same suppliers for 4 components.
    [buzzer.kicad_sch, gateway_BOM.csv, mcu.kicad_sch, rf.kicad_sch]
2025-10-19 EG-38 BOM re-generated to update the components witrh the same supplier fix.
    [gateway_BOM.csv]
2025-10-19 EG-38 Gerbers generated.
    [gateway.kicad_pcb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]
2025-10-20 Created REV0 without open with KiCad
    [buzzer_rev0.kicad_sch, gateway.kicad_sch, gateway_BOM.csv, gateway_rev0.kicad_pcb, main_rev0.kicad_sch, mcu_rev0.kicad_sch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]
2025-10-20 Parent folder changed to REV0, without errors.
    [buzzer_rev0.kicad_sch, gateway.kicad_sch, gateway_rev0.kicad_sch, mcu_rev0.kicad_sch, rf_rev0.kicad_sch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]
2025-10-20 REV1 ready
    [buzzer_rev1.kicad_sch, gateway_BOM.csv, gateway_rev1.kicad_pcb, gateway_rev1.kicad_sch, main_rev1.kicad_sch, mcu_rev1.kicad_sch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]
2025-10-20 Changed all references from REV0 to REV1 and update PCB silk screen.
    [buzzer_rev1.kicad_sch, gateway_rev1.kicad_pcb, mcu_rev1.kicad_sch, rf_rev1.kicad_sch]
2025-10-20 Schematic adapted for 433 MHz.
    [CC1101EM_434MHz_PARTLIST_2_0_0.xls, CC1101_CC1190EM_869MHz_PARTLIST_2_1_0.xls, rf_rev1.kicad_sch]
2025-10-20 RF passive components placed in the right relative positions.
    [gateway_rev1.kicad_pcb]
2025-10-20 All connections performed. Still with DRC errors on antenna footprint.
    [gateway_rev1.kicad_pcb]
2025-10-20 All connections finished, no DRC erros, gerbers and, components position and BOM generated.
    [gateway_BOM.csv, gateway_rev1.kicad_pcb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]
2025-10-20 Added the 3 fiducial points for pick and place machine.
    [gateway_rev1.kicad_pcb, gateway_rev1.kicad_sch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]
2025-10-21 Replaced 0402 by 0603 package where was possible.
    [buzzer_rev1.kicad_sch, gateway_rev1.kicad_pcb, mcu_rev1.kicad_sch]
2025-10-21 DRC errors fixed and silkscreen fixed.
    [buzzer_rev1.kicad_sch, gateway_rev1.kicad_pcb, rf_rev1.kicad_sch]
2025-10-21 Changed the paramerters to meet JLCPBC manufacturer capabilities.
    [gateway_BOM.csv, gateway_rev1.kicad_pcb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]
2025-10-21 Ready for production, with all fabric outputs generated.
    [gateway_BOM.csv, gateway_rev1.kicad_pcb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]
2025-10-23 BOM fixed and finance updated
    [Mouser_BOM.xls, buzzer_rev1.kicad_sch, gateway_BOM.csv, gateway_rev1.kicad_sch, mcu_rev1.kicad_sch, rf_rev1.kicad_sch, spend_log.csv]
2025-12-29 Expenses update and chinese transmitters decided.
    [spend_log.csv]
2025-12-29 EG-39 Project infrastructure setup, compiling and flashing, but no LEDs enabled. Don't know if it reaches main
2026-01-01 EG-39 An LED blinking is working on target, from reset vector to main.
    [main.c]
2026-01-03 EG-40 Included all peripheral drivers. Only clk driver working, setting the sysclk to 16 MHz.
2026-01-04 EG-40 MCU device drivers are integrated. Not all tested so far. Need to test I2C, SPI, UART and ADC.
2026-03-01 First version of CC1101 working in OOK.
    [spend_log.csv]
2026-03-17 Create the FERAM driver.
2026-03-17 Created the sensor manager SW module.
2026-03-17 Optimization of sensor manager, remove multiplication and base address sum, because it's always 0.
2026-03-19 First version of sensor manager, without review.
2026-03-21 Sensor Manager, first version, not tested.
2026-03-21 EG-23 Added the function to check for window sensors in open state.
2026-04-21 EG-34 Update the system requirements for REV2.0 sensors and gateway with AC-DC power supply.
2026-04-26 Update system requirements for sensor reporting and gateway functionality
2026-04-26 EG-34 Update system requirements to version 2.0.0 and enhance clarity in sensor and gateway functionalities
2026-04-26 EG-22 Enhance gateway functionality by adding input and LED aliases, and updating interrupt handlers for button and door sensors. Remove unused vector table file.
2026-04-26 EG-22 Add board initialization and interrupt handling functionality; include LED and input aliases
2026-05-01 EG-22 Button up and down events detected with debounce being handled.
2026-05-01 EG-22 Reed switch handled with debounce.
2026-05-01 EG-22 Button functionality implemented.
2026-05-01 EG-22 Button code moved to button SW module.
2026-05-02 EG-22 Moved the blue LED code to Led SW module.
2026-05-03 EG-22 LEDs SW module added.
2026-05-05 EG-22 Buzzer SW module implemented, but not tested.
    [buzzer.c, buzzer.h, main.c]
2026-05-09 EG-37 Update of architecture , system context, window sensor and gateway HW block diagrams.
2026-05-09 EG-22 Enable the buzzer.
    [board.c]
2026-05-17 EG-22 Able to receive frames packets.
2026-05-17 EG-22 Pair and unpair functionality, with bugs.
    [main.c, mode_manager.c, sensor_manager.c, sensor_manager.h]
2026-05-17 EG-22 Adding, removing sensors and update status of sensors is implemented.
2026-05-19 EG-22 Fixed bugs from reed switch code enable.
    [button.c, main.c, mode_manager.c, reed.c, sensor_manager.c]
2026-05-21 EG-22 Bug fixed: number of sensors in header updated.
    [main.c, sensor_manager.c]
2026-05-21 EG-22 Bug fix: at startup can trigger an alert.
    [main.c, mode_manager.c, sensor_manager.c, sensor_manager.h]
2026-05-23 EG-22 Sensor low battery handled.
2026-06-13 EG-43 RF and sensor design decisions. Missing sensor antenna and CC1101 balun. Missing electronic enclosure.
    [CC1101.xlsx]
2026-06-20 EG-43 Antenna and electronics enclosure information.
2026-06-24 EG-49 Initial REV1.0 project, from REV0.0.
    [sensor.kicad_pcb, sensor.kicad_sch, sensor.step, sensor_BOM.csv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]
2026-06-25 EG-49 Base the sensor REV1.0 on gateway REV1.0.
    [mcu_rev1.kicad_sch, rf_rev1.kicad_sch, sensor.kicad_pcb, sensor.kicad_sch, sensor.step, sensor_BOM.csv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]
2026-06-25 EG-49 Update the spending doc.
    [spend_log.csv]
2026-06-25 EG-49 Several components addes, such as bulk capacitors, battery holder, MCU and reed switches.
    [mcu_rev1.kicad_sch, rf_rev1.kicad_sch, sensor_rev1.kicad_pcb]
2026-07-04 EG-49 Takachi PCB format.
    [mcu_rev1.kicad_sch, sensor_rev1.kicad_pcb]
2026-07-12 EG-49 Improved CC1101 registers settings from new baudrate calculation.
    [CC1101.xlsx]
2026-07-12 EG-49 Technical documents and 3D design of sensor enclosure.
    [CS75-W.stp, CSPB-75.stp, CST-2032M..stp, CST-2032P..stp]
2026-07-14 EG-49 Added the CST2032 battery holder symbol.
2026-07-18 EG-49 CST2032 concluded and placed.
    [mcu_rev1.kicad_sch, sensor_rev1.kicad_pcb]
2026-07-18 EG-49 Board size and mounting holes placed.
    [mcu_rev1.kicad_sch, sensor_rev1.kicad_pcb, sensor_rev1.kicad_sch]
2026-07-18 EG-49 Board placed.
    [sensor_rev1.kicad_pcb]
2026-07-21 EG-49 Battery holder on the right place.
    [sensor_rev1.kicad_pcb]
2026-07-23 EG-49 Removed a bulk capacitor.
    [mcu_rev1.kicad_sch, rf_rev1.kicad_sch, sensor_rev1.kicad_pcb]
2026-07-24 EG-49 MCU schematic part is concluded.
    [mcu_rev1.kicad_sch, sensor_rev1.kicad_pcb]
2026-07-24 EG-49 All components from MCU schematic with links to supplier.
    [mcu_rev1.kicad_sch, sensor_rev1.kicad_pcb]
2026-07-25 EG-49 Adapted the MCU schematic ADC interface, reed interface and button interface. In summary, less components.
    [mcu_rev1.kicad_sch]
2026-07-25 EG-49 All components reviewed, MCU and RF.
    [mcu_rev1.kicad_sch, rf_rev1.kicad_sch, sensor_rev1.kicad_pcb]
2026-07-25 EG-49 All components parameters standardized for mouser.
    [mcu_rev1.kicad_sch, rf_rev1.kicad_sch]
2026-07-25 EG-49 Antenna hole placed.
    [mcu_rev1.kicad_sch, rf_rev1.kicad_sch, sensor_rev1.kicad_pcb]
2026-07-25 EG-49 Antenna supplier found.
2026-07-25 EG-49 Adjust antenna place in PCB.
    [mcu_rev1.kicad_sch, sensor_rev1.kicad_pcb]
2026-07-26 EG-49 Tests points added.
    [mcu_rev1.kicad_sch, rf_rev1.kicad_sch]
2026-07-26 EG-49 ERC with no errors.
    [mcu_rev1.kicad_sch, rf_rev1.kicad_sch, sensor_rev1.kicad_sch]
2026-07-26 EG-49 No ERC warnings.
    [mcu_rev1.kicad_sch, rf_rev1.kicad_sch]
2026-07-26 EG-49 PCB updated from schematic with no errors. BOM exported.
    [sensor_rev1.kicad_pcb, window_sensor_BOM.csv]
2026-08-01 EG-50 Components placed in the right faces.
    [sensor_rev1.kicad_pcb]
2026-08-02 EG-50 Components ready to be connected.
    [mcu_rev1.kicad_sch, rf_rev1.kicad_sch, sensor_rev1.kicad_pcb]
2026-08-02 EG-50 All pins connected, except ground planes.
    [mcu_rev1.kicad_sch, sensor_rev1.kicad_pcb]
2026-08-03 EG-50 All components connected.
    [sensor_rev1.kicad_pcb]
2026-08-04 EG-50 Fiducials included.
    [sensor_rev1.kicad_pcb, sensor_rev1.kicad_sch]
2026-08-04 EG-50 Top face ground plane included.
    [sensor_rev1.kicad_pcb]
2026-08-04 EG-50 Ground planes added.
    [sensor_rev1.kicad_pcb]
2026-08-05 EG-50 Components placed, ground planes connected.
    [sensor_rev1.kicad_pcb]
2026-08-05 EG-50 Components labels fixed.
    [sensor_rev1.kicad_pcb]
2026-08-08 EG-50 Placed vias in the non-RF part.
    [sensor_rev1.kicad_pcb]
2026-08-08 EG-50 DRC errors fixed. Only warnings.
    [sensor_rev1.kicad_pcb]
2026-08-08 EG-50 Only warings on CR2032 battery holder.
    [mcu_rev1.kicad_sch, rf_rev1.kicad_sch, sensor_rev1.kicad_pcb]
2026-08-08 EG-50 Fix the CR2032 battery holder footprint.
    [sensor_rev1.kicad_pcb]
2026-08-08 EG-50 PCB Finalized.
    [mcu_rev1.kicad_sch, rf_rev1.kicad_sch, sensor_rev1.kicad_pcb]
2026-08-08 EG-50 Final ERC Check.
    [sensor_rev1.kicad_pcb]
2026-08-08 EG-50 Bill of Materials.
    [mcu_rev1.kicad_sch, rf_rev1.kicad_sch, sensor_rev1.kicad_sch, window_sensor_BOM.csv]
2026-08-08 EG-50 All output files generated.
    [gateway_rev0-B_Cu.gbr, gateway_rev0-B_Mask.gbr, gateway_rev0-B_Paste.gbr, gateway_rev0-B_Silkscreen.gbr, gateway_rev0-Edge_Cuts.gbr, gateway_rev0-F_Cu.gbr, gateway_rev0-F_Mask.gbr, gateway_rev0-F_Paste.gbr]
2026-08-08 EG-50 Export the PCB 3D model.
    [sensor.step]
2026-08-08 EG-50 BOM fixed for Mouser.
    [window_sensor_BOM.csv]
2026-08-18 EG-50 JLBPCB PCB design rules.
2026-08-19 EG-50 Updated the PCB rules according with JLBPCB.
2026-08-19 EG-50 Fixes from new DRC rules (JLBPCB)
    [sensor_rev1.kicad_pcb]
2026-08-28 EG-70 All components in one face.
    [sensor_rev1.kicad_pcb, sensor_rev1.kicad_sch]
2026-08-28 EG-70 Output files for JLCPCB (from plugin)
    [bom.csv, designators.csv, positions.csv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]
2026-08-28 EG-70 BOM fix, components not assebled removed
    [bom.csv, positions.csv]
2026-08-28 EG-70 Updated the LED from JLCPCB library.
    [bom.csv, designators.csv, mcu_rev1.kicad_sch, positions.csv, sensor_rev1.kicad_pcb]
2026-08-28 EG-70 Adaptions according with JLCPCB production constraints.
    [bom.csv, mcu_rev1.kicad_sch, positions.csv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]
2026-08-28 EG-70 Fixed the BOM and the positions file.
    [bom.csv, positions.csv]
2026-08-28 EG-70 XTAL replaced according with JLCPCB constraints and capacitors adjusted accordingly.
    [bom.csv, mcu_rev1.kicad_sch, positions.csv, rf_rev1.kicad_sch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]
2026-08-28 EG-70 Adaptions on XTAL name.
    [bom.csv, positions.csv, rf_rev1.kicad_sch, sensor_rev1.kicad_pcb]
2026-08-28 EG-70 Gerbers generation.
    [bom.csv, positions.csv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]
2026-08-28 EG-70 Delete components from BOM and position file.
    [bom.csv, mcu_rev1.kicad_sch, positions.csv, sensor_rev1.kicad_pcb]
2026-08-29 EG-70 Changed the KiCad version from 9.0 to 10.0
    [bom.csv, positions.csv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]
2026-08-29 EG-70 BOM and position file adapted for JLCPCB
    [bom.csv, positions.csv]
2026-08-29 EG-70 Export the 3D model of PCB
    [sensor.step]
2026-08-30 Removed .history folders from kiCad to be tracked.
2026-08-30 EG-51 New Project
    [SIC5-9-2W.stp, Sensor.FCStd, sensor.FCStd]
2026-08-30 EG-51 Files imported.
    [CS75-W.stp, Sensor.FCStd]
2026-08-30 EG-51 Both files imported and assembly created.
    [Sensor.FCStd]
2026-08-31 EG-51 Assembly created, with toggle grounded on enclosure
    [Sensor.FCStd]
2026-08-31 EG-51 Remove the track of FreeCad backup files.
2026-08-31 EG-51 PCB aligned with the enclosure.
    [Sensor.FCStd]
2026-08-31 EG-51 PCB fits inside enclosure.
    [Sensor.FCStd]
2026-08-31 EG-51 Instructions to check if the PCB fits into the enclosure.
2026-08-31 Connected the XTAL NC/GND pins to GND. Added a via for decouple capacitors of CC1101.
    [mcu_rev1.kicad_sch, rf_rev1.kicad_sch, sensor_rev1.kicad_pcb, sensor_rev1.kicad_sch]
2026-08-31 Final adjustments to PCB and schematic after review session.
    [rf_rev1.kicad_sch, sensor_rev1.kicad_pcb]
2026-08-31 Generation of gerbers, drills, components positions and BOM.
    [sensor_rev1-B_Cu.gbr, sensor_rev1-B_Mask.gbr, sensor_rev1-B_Paste.gbr, sensor_rev1-B_Silkscreen.gbr, sensor_rev1-Edge_Cuts.gbr, sensor_rev1-F_Cu.gbr, sensor_rev1-F_Mask.gbr, sensor_rev1-F_Paste.gbr]
2026-08-31 Generation of JLCPCB pruduction files.
    [bom.csv, positions.csv]
2026-08-31 BOM and positions fixed for production.
    [bom.csv, positions.csv]
2026-09-05 Update the finance data.
    [funding_log.csv, spend_log.csv]
2026-09-06 EG-59 Initial project, based on rev1 gateway project.
    [buzzer_rev2.kicad_sch, gateway_rev2.kicad_pcb, gateway_rev2.kicad_sch, mcu_rev2.kicad_sch, rf_rev2.kicad_sch]
2026-09-06 EG-59 Fixed the sub-schematics tree with REV2 updated.
    [buzzer_rev2.kicad_sch, gateway_rev2.kicad_sch, mcu_rev2.kicad_sch, rf_rev2.kicad_sch]
2026-09-09 EG-59 Adapted the buzzer driver.
    [buzzer_rev2.kicad_sch, mcu_rev2.kicad_sch]
2026-09-12 EG-56 Initial project, with a blink LED.
2026-09-13 EG-56 Adapted the code to send 4 bytes. Still not working.
    [board.c, cc1101.c, cc1101.h, log.c, log.h, main.c]
2026-09-14 EG-56 LED blinking with timer 4 with interrupt.
2026-09-15 EG-56 External button interrupt is working.
2026-10-03 EG-56 Requirements and Architecture to use a sensor on main-door
    [spend_log.csv]
2026-10-04 EG-59 Schematic with the needed components, plus PCB.
    [buzzer_rev2.kicad_sch, gateway.step, gateway_rev2.kicad_pcb, gateway_rev2.kicad_sch, mcu_rev2.kicad_sch, rf_rev2.kicad_sch]
2026-10-04 EG-59 First mechanical project with the AC-DC component and buzzer.
    [OKW-B5013227.STEP, SIC6-12-4W.stp, gateway.FCStd, gateway.step, gateway_rev2.kicad_pcb, mcu_rev2.kicad_sch]
2026-10-04 EG-59 Correct position of AC-DC and buzzer in the PCB.
    [gateway.FCStd, gateway_rev2.kicad_pcb, mcu_rev2.kicad_sch]
2026-10-04 EG-59 Antenna and headers fix, from schematic to 3D.
    [gateway_rev2.kicad_pcb, mcu_rev2.kicad_sch]
2026-10-10 EG-59 Schematic finished.
    [gateway_rev2.kicad_pcb, mcu_rev2.kicad_sch]
2026-10-10 EG-59 Board shape finished. Button, LEDs, AC-DC and buzzer placed.
    [gateway_rev2.kicad_pcb]
2026-10-15 EG-59 All components connected except GND.
2026-10-18 EG-59 GND plane added.
2026-10-25 EG-59 Components in PCB updated from fixed sch.
2026-10-30 EG-59 Pre-production, and pre- check in electronic enclosure.
2026-11-03 EG-64 Enclosure with PCB concluded.
